anomaddev/Brewski/README.md

# Brewski

Brewski is a local web controller for a small still. A Python program runs the heater logic and stores every run. A plain JavaScript dashboard, in a dark layout, shows live temperatures, heater state, and the history of those runs.

The installed controller drives the live Pi wiring: the heater SSRs, the MAX31865 still probes, and the HTS221 cabinet sensor. `brewski dev` on a Mac uses a **dummy source** that simulates a still, so the dashboard can be built without that hardware. The installed service never falls back to the dummy source.

## What a run does

A run is one session of the still.

- **First launch.** A new controller, and one that has just had all data reset, opens a setup overlay. It asks for the heaters, the probes, the panel pins, the SPI and I2C bus, the target temperature, and the still size in gallons. A normal run stays locked until a calibration has measured the coast.
- **Idle.** The probes still report temperature. Heaters are off. Nothing new is written to the log unless the previous run is still cooling down.
- **Start.** Brewski copies the current setup onto the run: target temperature, which heaters and probes are enabled, their names, and their GPIO pins. The clock starts at zero. Starting during a cooldown leaves that cooldown unfinished, and it is left out of the average. Start is refused until a calibration has been saved.
- **Running.** About once a second the controller reads the probes. **The first enabled probe is the only one that controls the heaters.** Enabled heaters turn off early, by the early cutoff (3°F unless changed in Settings), so heat still stored in the element can carry the liquid the rest of the way to the target. Without a measured cooling rate they turn back on when the probe falls 2°F below that cutoff, and between those two points they stay as they are. Once calibration has measured how fast the pot cools, a run still turns the elements off at the cutoff. Near the target they stay off until the probe sags about 1°F, then run one short pulse timed from that cooling rate, instead of waiting until the probe has fallen the whole coast. A heater that has just turned on stays on for at least the minimum on time, and one that has just turned off stays off for at least the minimum off time (each 1 second unless changed). Both dwells keep a zero-crossing SSR from chattering. Pause and Stop still turn the heaters off immediately. Disabled heaters stay off. Every 5 seconds a sample is saved: each probe temperature, each heater on or off, and the target at that moment.
- **Pause.** Heaters are forced off and the run clock stops. Live temperatures are still shown. Paused time is not added to the log.
- **Stop.** Heaters turn off, the run is closed as **Stopped**, and the setup snapshot plus the sample log stay in the history.
- **Calibrate.** From the dashboard, with the pot filled with water, Calibrate heats until the control probe is a little above the target. The early cutoff is not used, so the still can actually reach the setpoint and coast past it. Once the element has been hot for 30 seconds and turns off, Brewski watches a rolling average of that probe until the average crests and turns down. A slow climb does not end the run. The degrees from shutoff to that peak, and how long that took, become the early cutoff. Brewski then leaves the elements off and measures how fast the pot cools, in °F per minute. The LCD names each step: Heating, Coasting with the live rise, Falling with the peak and then the rate, and Paused with the step that was interrupted. After the run closes, the cooling screen shows the saved coast and the rate. The calibration uses the still size from setup. A different size on a later calibration scales the remembered coast and the cooling rate, then the measurement replaces them. An older coast that has no cooling rate still allows a run, and the dashboard asks for another calibration. Calibration runs stay in the log with their own badge and are left out of the run count, average duration, average cooldown, and the per-run heater-on totals. They still add to each element's hour meter, because the element was powered.
- **Cooldown.** A cooldown is the stretch from the target temperature to the lower stop. Timing starts the first time the control probe reaches the target, including the rest of the run. After Stop, heaters stay off, and the lower stop is when that probe stays inside a 2°F band for 5 minutes. Those readings stay on the dashboard chart, and the time is saved. The dashboard and the history page show the average of every finished cooldown. A run that never reaches its target has no cooldown.

Each heater and each probe can be enabled or disabled on its own. Changing names, which devices are enabled, a heater's GPIO pin, a probe's MAX31865 chip select, RTD, wire count, or reference resistor, or any other GPIO pin, is locked while a run is open. The target temperature, the cabinet limit, the early cutoff, and the minimum on and off times can still be changed; later samples record the new target, and the run keeps the target it started with. The target dial on the panel changes that same target by 1°F, from 90 to 240.

The HTS221 is not a process temperature. It watches the cabinet. If it is enabled and the cabinet rises above the cabinet limit (170°F unless changed, allowed from 100 to 200), Brewski opens every SSR immediately, stops and saves an open run, and refuses Start until the cabinet is back at the limit. The controller process keeps running so the SSR pins stay driven off. Humidity is shown and does not trip the stop. Disabling the HTS221 turns the interlock off.

## Emergency codes

`src/brewski/emergency.py` is the only list. A new fault takes the next number there and a line here. Numbers are not reused. The LCD shows the lowest active code. The dashboard and the status strip show every active code and its sentence. Heaters stay off and Start stays refused while any code is active.

- `E01` — cabinet temperature is above the cabinet limit.
- `E02` — the HTS221 is enabled and does not answer.
- `E03` — the control probe faulted or did not answer.
- `E04` — the SPI bus did not open, or the saved SPI pins are not the hardware bus.

Any enabled probe after the control probe is logged and charted only. It does not decide when the heaters fire.

## Pi source

`brewski` with no command, including the systemd service, uses `src/brewski/sources/pi.py`. There is no switch back to the dummy source. A missing still probe or a failed SPI open leaves that reading empty and keeps every SSR off. A missing HTS221 trips the cabinet emergency only when that sensor is enabled.

- **SSRs.** gpiozero outputs on each heater's BCM pin, active high. Forced off on startup, shutdown, pause, stop, a control-probe fault, and any emergency code. Defaults are BCM 12 and 16.
- **MAX31865.** Hardware SPI0 only when the saved pins are CLK 11, MOSI 10, and MISO 9. Chip select is a separate GPIO, so probe 1 can use BCM 17. The driver uses the saved wire count, PT100 or PT1000 type, and reference resistor. Any other SPI pin set is left unread.
- **HTS221.** smbus2 on I2C bus 1 at `0x5F`, only when the sensor is enabled and SDA/SCL are BCM 2 and 3.

The LCD is a 20×4 I2C display on the saved SDA and SCL pins, after setup. Saved BCM 2 and 3 use the Pi's hardware bus. The running controller keeps the start and stop buttons, their LED relays, and the target encoder open. An LED is solid on only while that button will do something. While Stop is held, its lamp stays dark until the hold is long enough, then comes on, and goes out again when the button is released. The boot update prompt turns both LEDs on and does not blink them.

Holding Stop for 4 seconds while the still is idle or cooling opens a Software Menu on that display: About, Check for Update, and Reboot. The same hold opens it while an emergency code is showing, so the still can be rebooted or updated without the dashboard. The dial moves the highlight, Start chooses it, and Stop goes back. The hold is ignored during a run or a pause, and a short press of Stop still stops a running or paused run. Check for Update uses the same installer as the dashboard. Reboot asks for confirmation, then reboots the Pi. The install grants the service account passwordless `systemctl reboot` for that.

The installer enables SPI and I2C and adds the service user to the `spi`, `i2c`, and `gpio` groups. The Pi may need one reboot before `/dev/spidev0.0` appears.

## Dummy source

`DummySource` is only for `brewski dev` on a Mac, and for tests. Two heaters together lift the boiler from about 70°F toward a 165°F target in a few minutes. That is faster than a real still, on purpose, so the chart moves while the UI is being designed. After the heaters turn off, stored element heat keeps raising the boiler for a few seconds, then it cools back toward room temperature. Sensor 2 lags sensor 1 and sits about 8°F cooler. The cabinet reading stays at room temperature, under the limit.

The status payload includes `"source": "dummy"` for dev and `"source": "pi"` on the installed controller. The dashboard badge reads **Dummy source** or **Pi**. The dummy source ignores heater, probe, and SPI pin numbers.

- `read_temperatures(count)` returns `count` temperatures in °F, sensor 1 first.
- `set_heaters(states)` turns each heater on or off, heater 1 first.

Those methods live in `src/brewski/sources/base.py`. The dummy implementation is `src/brewski/sources/dummy.py`.

## Develop on a Mac

From a checkout of this repo:

```bash
python3 -m venv .venv
source .venv/bin/activate
pip install -e ".[dev]"
npm install --prefix web
brewski dev
```

- API: http://127.0.0.1:5000
- Dashboard: http://127.0.0.1:5173

The Vite dev server reloads the UI as you edit `web/`, and it proxies `/api` to the Python process. The database for dev mode is `./data/brewski.db`.

`BREWSKI_HOST`, `BREWSKI_PORT`, and `BREWSKI_DATA_DIR` override the API bind address and the database directory. `BREWSKI_DEV_PORT` changes the Vite port (default 5173).

Run the tests with `pytest`.

## Install on a Raspberry Pi

Git is not required. On the Pi:

```bash
curl -fsSL https://raw.githubusercontent.com/anomaddev/Brewski/main/deploy/install.sh | sudo bash
```

That installs the latest GitHub release, then enables a systemd service so the controller starts on every reboot. The database is kept at `/var/lib/brewski/brewski.db`. The service listens on port 8080. Open `http://<pi-address>:8080`.

A fresh boot does not look for an update. The I2C pins are not known until setup saves them, and the LCD stays closed. Finish setup in the dashboard first. That write is stored before any update check. If a newer release exists, the same screen offers it. Update installs that release and keeps the setup that was just saved. Not now leaves the current version running.

The next boot, once setup is saved, asks on the LCD when a newer release exists. Start and Stop are both lit, solid. Start downloads and installs it, with each stage on the display. Stop, or a minute with no press, starts the version already on the Pi. If GitHub cannot be reached, the LCD cannot be opened, or the saved pins are not BCM 2 and 3, Brewski starts the installed version and does not update on its own. Commits on `main` stay off the Pi until they are published as a release. After the controller is up, the LCD shows the mode and clock, the target, the probe or probes, and both heaters. During a calibration those first lines name the step instead: Heating, Coasting, Falling, and then the saved coast and cooling rate while the pot cools. A still that has never been calibrated asks for Start. An emergency code replaces that screen until it clears.

The service runs as the account that invoked `sudo`, or as `pi` when that account exists and sudo did not record a user. Set `BREWSKI_USER` to choose a different account:

```bash
curl -fsSL https://raw.githubusercontent.com/anomaddev/Brewski/main/deploy/install.sh \
  | sudo BREWSKI_USER=still bash
```

From a checkout that is already on the Pi, `sudo ./deploy/install.sh` installs that checkout and does not contact GitHub.

Running the script again upgrades Brewski and restarts the service. It does not delete the database. Dev mode (`brewski dev`) does not need this install.

## What is stored

SQLite, one file. There is no separate database server.

**Settings** (one row): the target in °F, the cabinet limit, and for each of the two heaters and two probes a name, an enabled switch, and a BCM pin. A heater pin drives its SSR. A probe pin is the chip select of that probe's MAX31865. A probe name is 1 to 11 characters. A heater name can be 40. The same row stores the rest of the BCM map: SPI CLK, SDO, and SDI; I2C SDA and SCL; enable switches for the HTS221 and the LCD on that bus; encoder A and B; the start and stop LED relays; and the start and stop buttons. Every pin in that map, including both heaters and both chip selects, must be unique and from BCM 2 to 27. Each probe also stores its RTD (`pt100` or `pt1000`), wire count (2, 3, or 4), and reference resistor in ohms. Disabling a device keeps its name and wiring. Defaults are BCM 12 and 16 for the heaters and chip selects BCM 17 and 8 for the probes. Probe 2 starts disabled. SPI defaults are BCM 11, 9, and 10. I2C defaults are BCM 2 and 3, with the HTS221 and the LCD enabled. The encoder defaults are BCM 27 and 22, the LED relays BCM 23 and 24, and the buttons BCM 5 and 6. Each probe starts as a 2-wire PT100 with a 430 Ω reference. The allowed target range is 90–240°F. The cabinet limit defaults to 170°F and accepts 100–200. I2C addresses are not stored. The LCD probes `0x27`, then `0x3F`.

**Runs:** start time, end time, status (`running`, `paused`, or `stopped`), elapsed seconds (the pause does not add time), and a snapshot of the settings from the moment Start was pressed.

**Samples:** time, elapsed seconds, temperatures, heater states, and the target that was active when the sample was written.

Time each heater spent on during a run is estimated from that log and shown on the history page. A sample's heater state is treated as holding until the next sample.

**Element hours:** seconds each heater output has actually been on, including calibration and every run. The controller adds that time as it happens and keeps it when run data is reset. The dashboard, the history overview, and Settings show the total in hours. Replacing an element in Settings zeros that heater so the new one starts at zero. A database from before this meter existed is filled once from its sample log.

## Layout

```
src/brewski/          Python controller, API, and CLI
src/brewski/sources/  Hardware contract, the Pi source, and the Mac dummy still
web/                  Vite dashboard (plain JavaScript, no TypeScript)
deploy/               Pi install script and systemd unit
tests/
```

`brewski` with no arguments serves the API and, when it has been built, the dashboard. `brewski dev` is the Mac development command described above.
