anomaddev/Brewski/pcb_design/Brewski Pi Still Controller HAT/Project Brief.md

# Brewski Pi Still Controller HAT

A Raspberry Pi HAT for a small still controller featuring an integrated I2C hub, SSR control headers for external heater relays, optoisolated indicator lamp drivers, and interfaces for temperature probes, a rotary dial, and momentary switches.
