anomaddev/Brewski/pcb_design/Brewski Pi Still Controller HAT/.protoflow/studio/knowledge.md

# Brewski Pi HAT: project knowledge
Pi HAT: 5V in, SSR drivers, MOC3063 lamp drivers, STEMMA I2C hub, probe sockets, encoder/button terminals.

## Status
- Phase: Choosing parts
- 5V input & rails: planned
- SSR drivers: planned
- Lamp optocouplers (mains side): planned
- Buttons & dial: planned
- STEMMA hub: planned
- MAX31865 sockets: planned
- Pi header: planned

## Next steps
1. Select and import parts
2. Build schematic
3. ERC
