anomaddev/Brewski/pcb_design/Brewski Pi Still Controller HAT/.protoflow/previews/schematic-5.png

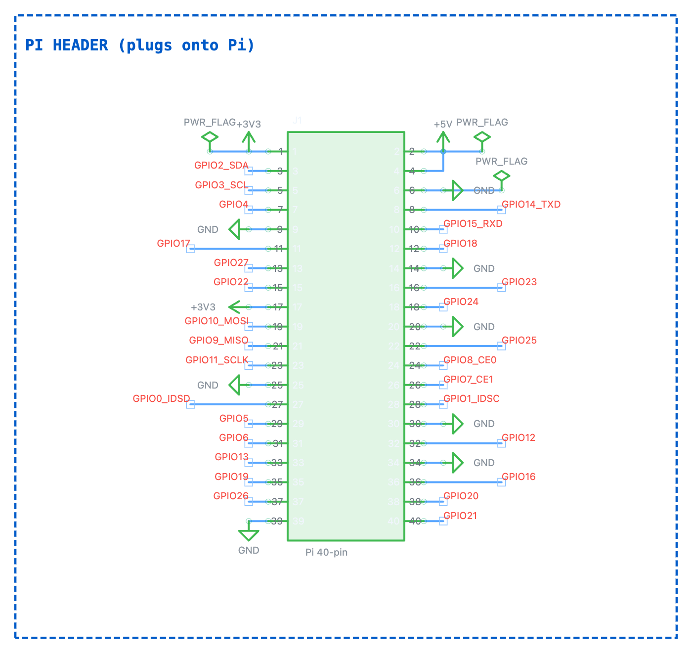
pcb_design/Brewski Pi Still Controller HAT/.protoflow/previews/schematic-5.png
