anomaddev/Brewski/(list of files, drawings)

Other design files:
pcb_design/Brewski Pi Still Controller HAT/.protoflow/studio/schematic-build.json
