anomaddev/Brewski/pcb_design/Brewski Pi Still Controller HAT/Brewski Pi Still Controller HAT.kicad_sch

## KiCad design pcb_design/Brewski Pi Still Controller HAT/Brewski Pi Still Controller HAT.kicad_sch (2026-10-19)

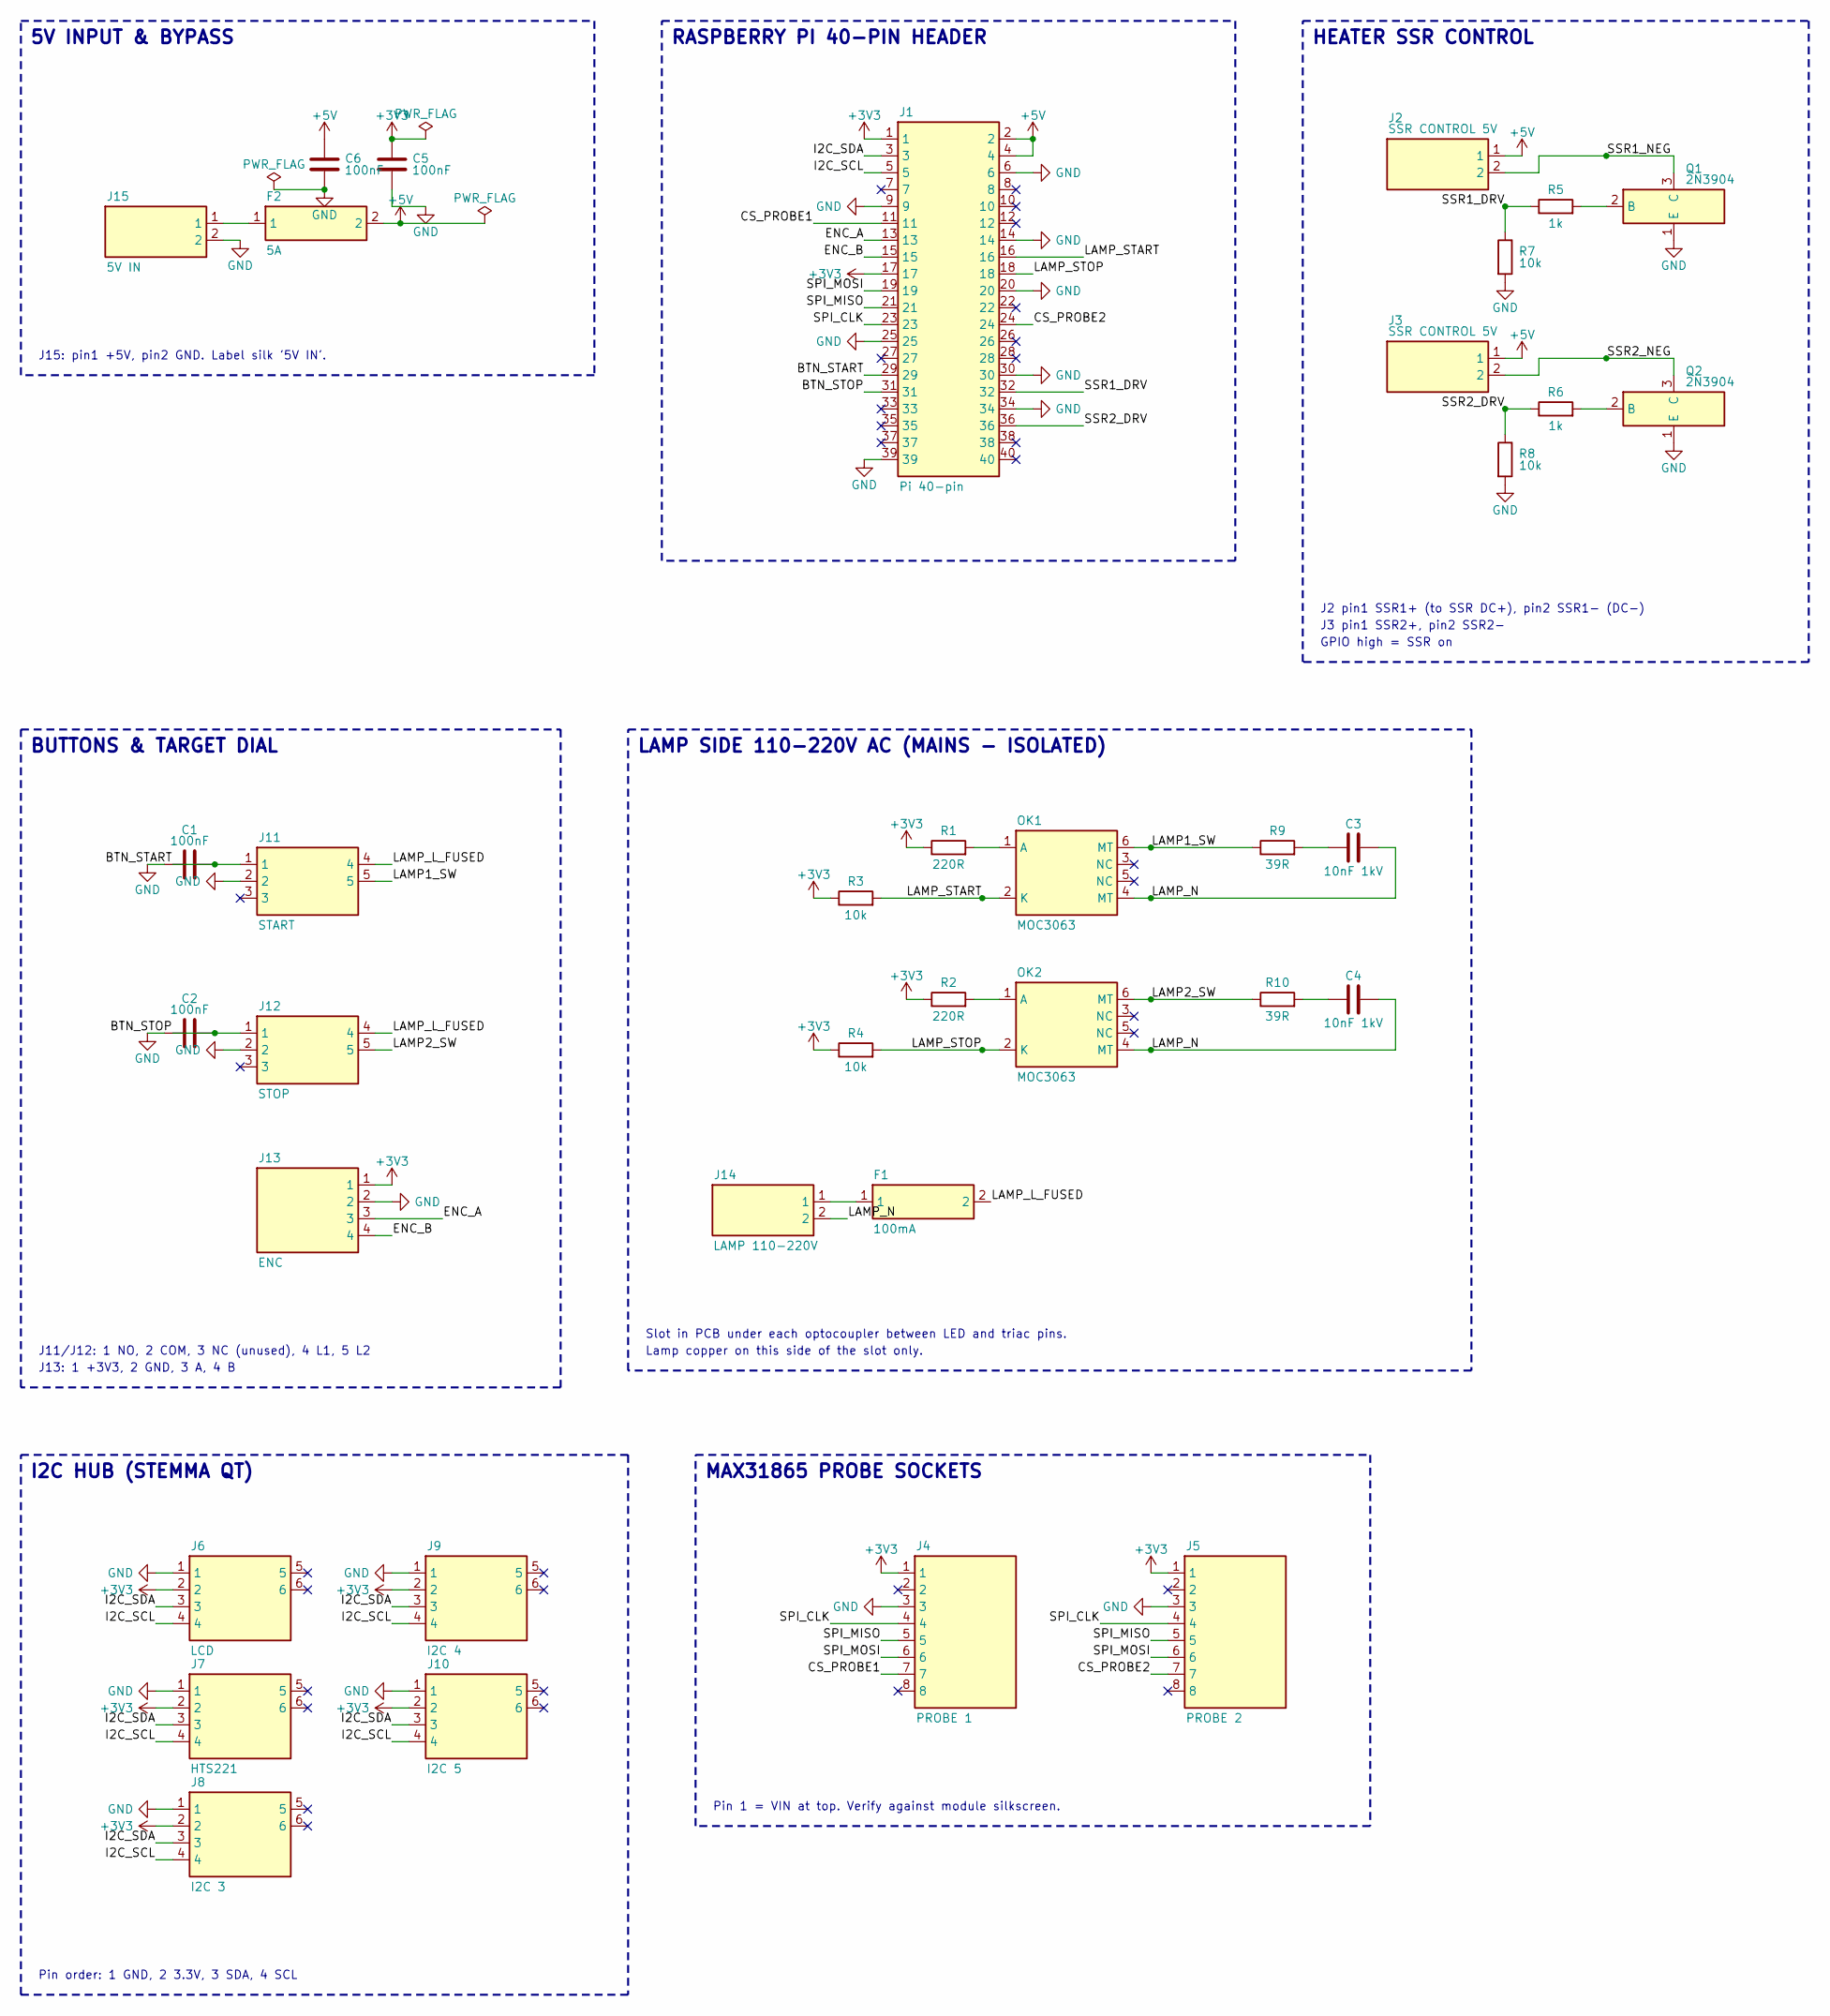
[picture p7: schematic Brewski Pi Still Controller HAT.kicad_sch]

Parts:
C1, C2, C5, C6: 100nF; C_0805_2012Metric; LCSC C49678
C3, C4: 10nF 1kV; C_1206_3216Metric; LCSC C394163
F1: 100mA; FUSE-TH_L8.4-W4.0-P5.08-D0.6; MPN JFS0100TR; LCSC C55042406
F2: 5A; FUSE-SMD_L9.8-W5.1; MPN 0154005.DR; LCSC C206916
J1: Pi 40-pin; HDR-TH_40P-P2.54-V-F-R2-C20-S2.54; MPN 2.54-2*20; LCSC C2977589
J2, J3: SSR CONTROL 5V; CONN-TH_P5.08_KF128-5.08-2P; MPN KF128-5.08-2P-AA; LCSC C474952
J4: PROBE 1; HDR-TH_8P-P2.54-V-F; MPN 2.54-1*8P母环保; LCSC C27438
J5: PROBE 2; HDR-TH_8P-P2.54-V-F; MPN 2.54-1*8P母环保; LCSC C27438
J6: LCD; CONN-SMD_4P-P1.00_SM04B-SRSS-TB-LF-SN; MPN SM04B-SRSS-TB(LF)(SN); LCSC C160404
J7: HTS221; CONN-SMD_4P-P1.00_SM04B-SRSS-TB-LF-SN; MPN SM04B-SRSS-TB(LF)(SN); LCSC C160404
J8: I2C 3; CONN-SMD_4P-P1.00_SM04B-SRSS-TB-LF-SN; MPN SM04B-SRSS-TB(LF)(SN); LCSC C160404
J9: I2C 4; CONN-SMD_4P-P1.00_SM04B-SRSS-TB-LF-SN; MPN SM04B-SRSS-TB(LF)(SN); LCSC C160404
J10: I2C 5; CONN-SMD_4P-P1.00_SM04B-SRSS-TB-LF-SN; MPN SM04B-SRSS-TB(LF)(SN); LCSC C160404
J11: START; CONN-TH_5P-P5.08_DIBO_DB128V-5.08-5P-GN-S; MPN DB128V-5.08-5P-GN-S; LCSC C2927513
J12: STOP; CONN-TH_5P-P5.08_DIBO_DB128V-5.08-5P-GN-S; MPN DB128V-5.08-5P-GN-S; LCSC C2927513
J13: ENC; CONN-TH_4P-P5.08_DIBO_DB128V-5.08; MPN DB128V-5.08-4P-GN-S; LCSC C2915641
J14: LAMP 110-220V; CONN-TH_P5.08_KF128-5.08-2P; MPN KF128-5.08-2P-AA; LCSC C474952
J15: 5V IN; CONN-TH_P5.08_KF128-5.08-2P; MPN KF128-5.08-2P-AA; LCSC C474952
OK1, OK2: MOC3063; DIP-6_L8.5-W6.4-P2.54-LS7.6-BL; MPN MOC3063M; LCSC C8920
Q1, Q2: 2N3904; SOT-23-3_L2.9-W1.3-P1.90-LS2.4-TR; MPN 2N3904S-RTK/PS; LCSC C18536
R1, R2: 220R; R_0805_2012Metric; LCSC C17557
R3, R4, R7, R8: 10k; R_0805_2012Metric; LCSC C17414
R5, R6: 1k; R_0805_2012Metric; LCSC C17513
R9, R10: 39R; R_0805_2012Metric; LCSC C543525

Connections:
+3V3: C5.1, J1.1, J1.17, J4.1, J5.1, J6.2, J7.2, J8.2, J9.2, J10.2, J13.1, R1.1, R2.1, R3.1, R4.1
+5V: C6.1, F2.2, J1.2, J1.4, J2.1, J3.1
BTN_START: C1.2, J1.29, J11.1
BTN_STOP: C2.2, J1.31, J12.1
CS_PROBE1: J1.11, J4.7
CS_PROBE2: J1.24, J5.7
ENC_A: J1.13, J13.3
ENC_B: J1.15, J13.4
GND: C1.1, C2.1, C5.2, C6.2, J1.6, J1.9, J1.14, J1.20, J1.25, J1.30, J1.34, J1.39, J4.3, J5.3, J6.1, J7.1, J8.1, J9.1, J10.1, J11.2, J12.2, J13.2, J15.2, Q1.1 (E), Q2.1 (E), R7.2, R8.2
I2C_SCL: J1.5, J6.4, J7.4, J8.4, J9.4, J10.4
I2C_SDA: J1.3, J6.3, J7.3, J8.3, J9.3, J10.3
LAMP1_SW: J11.5, OK1.6 (MT), R9.1
LAMP2_SW: J12.5, OK2.6 (MT), R10.1
LAMP_L_FUSED: F1.2, J11.4, J12.4
LAMP_N: C3.2, C4.2, J14.2, OK1.4 (MT), OK2.4 (MT)
LAMP_START: J1.16, OK1.2 (K), R3.2
LAMP_STOP: J1.18, OK2.2 (K), R4.2
unnamed: C3.1, R9.2
unnamed: C4.1, R10.2
unnamed: F1.1, J14.1
unnamed: F2.1, J15.1
unnamed: OK1.1 (A), R1.2
unnamed: OK2.1 (A), R2.2
unnamed: Q1.2 (B), R5.2
unnamed: Q2.2 (B), R6.2
SPI_CLK: J1.23, J4.4, J5.4
SPI_MISO: J1.21, J4.5, J5.5
SPI_MOSI: J1.19, J4.6, J5.6
SSR1_DRV: J1.32, R5.1, R7.1
SSR1_NEG: J2.2, Q1.3 (C)
SSR2_DRV: J1.36, R6.1, R8.1
SSR2_NEG: J3.2, Q2.3 (C)

Notes on the sheet:
5V INPUT & BYPASS
J15: pin1 +5V, pin2 GND. Label silk '5V IN'.
RASPBERRY PI 40-PIN HEADER
HEATER SSR CONTROL
J2 pin1 SSR1+ (to SSR DC+), pin2 SSR1- (DC-)
J3 pin1 SSR2+, pin2 SSR2-
GPIO high = SSR on
BUTTONS & TARGET DIAL
J11/J12: 1 NO, 2 COM, 3 NC (unused), 4 L1, 5 L2
J13: 1 +3V3, 2 GND, 3 A, 4 B
LAMP SIDE 110-220V AC (MAINS - ISOLATED)
Slot in PCB under each optocoupler between LED and triac pins.
Lamp copper on this side of the slot only.
I2C HUB (STEMMA QT)
Pin order: 1 GND, 2 3.3V, 3 SDA, 4 SCL
MAX31865 PROBE SOCKETS
Pin 1 = VIN at top. Verify against module silkscreen.
