anomaddev/Brewski/pcb_design/Brewski Pi Still Controller HAT/breakout/Pi Header Breakout.kicad_sch

## KiCad design pcb_design/Brewski Pi Still Controller HAT/breakout/Pi Header Breakout.kicad_sch (2026-10-19)

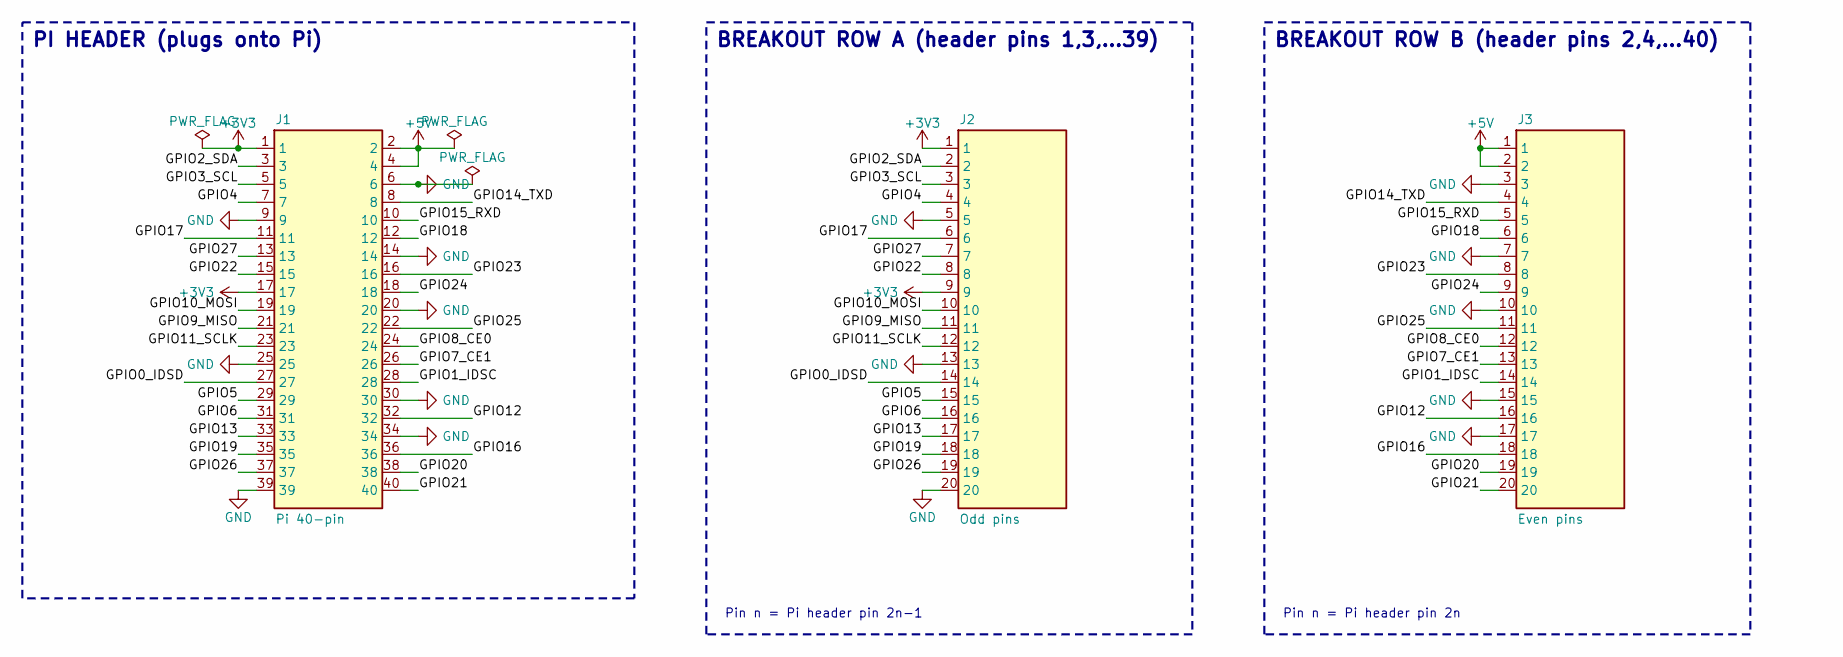
[picture p8: schematic Pi Header Breakout.kicad_sch]

Parts:
J1: Pi 40-pin; HDR-TH_40P-P2.54-V-F-R2-C20-S2.54; MPN 2.54-2*20; LCSC C2977589
J2: Odd pins; HDR-TH_20P-P2.54-V-M-1; MPN 2.54-1*20P直针; LCSC C50981
J3: Even pins; HDR-TH_20P-P2.54-V-M-1; MPN 2.54-1*20P直针; LCSC C50981

Connections:
+3V3: J1.1, J1.17, J2.1, J2.9
+5V: J1.2, J1.4, J3.1, J3.2
GND: J1.6, J1.9, J1.14, J1.20, J1.25, J1.30, J1.34, J1.39, J2.5, J2.13, J2.20, J3.3, J3.7, J3.10, J3.15, J3.17
GPIO0_IDSD: J1.27, J2.14
GPIO1_IDSC: J1.28, J3.14
GPIO2_SDA: J1.3, J2.2
GPIO3_SCL: J1.5, J2.3
GPIO4: J1.7, J2.4
GPIO5: J1.29, J2.15
GPIO6: J1.31, J2.16
GPIO7_CE1: J1.26, J3.13
GPIO8_CE0: J1.24, J3.12
GPIO9_MISO: J1.21, J2.11
GPIO10_MOSI: J1.19, J2.10
GPIO11_SCLK: J1.23, J2.12
GPIO12: J1.32, J3.16
GPIO13: J1.33, J2.17
GPIO14_TXD: J1.8, J3.4
GPIO15_RXD: J1.10, J3.5
GPIO16: J1.36, J3.18
GPIO17: J1.11, J2.6
GPIO18: J1.12, J3.6
GPIO19: J1.35, J2.18
GPIO20: J1.38, J3.19
GPIO21: J1.40, J3.20
GPIO22: J1.15, J2.8
GPIO23: J1.16, J3.8
GPIO24: J1.18, J3.9
GPIO25: J1.22, J3.11
GPIO26: J1.37, J2.19
GPIO27: J1.13, J2.7

Notes on the sheet:
PI HEADER (plugs onto Pi)
BREAKOUT ROW A (header pins 1,3,...39)
Pin n = Pi header pin 2n-1
BREAKOUT ROW B (header pins 2,4,...40)
Pin n = Pi header pin 2n
