anomaddev/Brewski/src/brewski/controller.py

"""Run state machine.

The loop is hardware-agnostic. It reads a :class:`HardwareSource`, decides
whether the heaters should be on, and appends samples while a run is going.
A timeline reading is saved on the same cadence whether or not a run is open,
so the dashboard can scroll the controller clock after a reload.
The first enabled probe is the one compared with the target. Once a
calibration has saved a heating model, heaters turn off when the predicted
crest reaches the target, stay off while that projected coast is still
arriving, then hold the target with pulses sized on the heater-on curve
so they land on it, and not past it, until the run stops, the hold
timer ends, or the max program duration is reached.
Until that model exists they turn off by the measured coast, and sooner
when the pot is rising faster than that measurement, so heat still stored
in the element can finish the rise. Disabled heaters stay off.
The installed service drives the SSRs,
the MAX31865 probes, and the HTS221. After setup, this loop also drives
the I2C LCD, the panel buttons, the LED relays, and the target encoder.
"""

from __future__ import annotations

import io
import logging
import math
import subprocess
import threading
import time
import weakref
import zipfile
from dataclasses import replace

from brewski import __version__, analysis
from brewski.calibration import MARK_HOLDING, MARK_START, CalibrationSession
from brewski.consolelog import ConsoleCapture, console_log_text
from brewski.emergency import summary
from brewski.lcd import (
    Display,
    NullDisplay,
    display_key,
    open_display,
    startup_lines,
    status_lines,
    suite_result_lines,
    suite_run_lines,
)
from brewski.menu import SoftwareMenu
from brewski.network import display_identity
from brewski.panel import indicator_leds, open_panel, panel_key
from brewski.program import MAX_DURATION_SECONDS, Program, program_end
from brewski.runlog import (
    analysis_message,
    clean_detail,
    decision_fields,
    control_log_csv,
    format_control,
    model_message,
    model_numbers,
    suite_result_message,
    phase_keys,
    phase_message,
    start_message,
)
from brewski.sources.base import HardwareSource
from brewski.suite import TEST_INITIAL_HEATING, InitialHeatingSession
from brewski.updates import (
    ReleaseInfo,
    apply_supported,
    check_release,
    installed_revision,
    read_status,
    report as update_report,
    request_reboot,
    start_apply_service,
    write_status,
)
from brewski.store import (
    EARLY_CUTOFF_MAX_F,
    SLOT_COUNT,
    TARGET_MAX_F,
    TARGET_MIN_F,
    Settings,
    SettingsError,
    Store,
    charge_gallons,
    default_gpio,
    heater_on_seconds,
    merge_settings,
    shape_changed,
    utc_now,
)
from brewski.thermal import (
    CALIBRATION_TEMP_F,
    HOLD_BAND_F,
    HOLD_RISE_F_PER_SEC,
    HOLD_SLOPE_MIN_SPAN_SECONDS,
    HOLD_SLOPE_WINDOW_SECONDS,
    LEARN_TEMP_F,
    GROK_RATE_BAND_F_PER_MIN,
    GROK_RATE_BAND_F_PER_SEC,
    ARRIVAL_F,
    GROK_RISE_BAND_F,
    SAFE_TEMP_F,
    ThermalModel,
    accept_grok,
    apply_grok_value,
    blend_model,
    coast_entry_slope,
    coast_settle_seconds,
    coast_tau_of,
    endpoint_rate,
    hold_maintenance_plan,
    hold_pulse_landing,
    model_from_dict,
    project_temperature,
    pulse_plan,
    remaining_coast_f,
    scale_model,
    seconds_to_landing,
    step_sheath_slope,
)
from brewski.timeline import TIMELINE_COMPACT_SECONDS

logger = logging.getLogger(__name__)

# Width of the hysteresis band. The element turns back on only after the
# probe falls this far below the early-cutoff temperature.
DEADBAND_F = 2.0
# After a run, cooldown stays open while the control probe is above 100°F.
SAMPLE_INTERVAL_SECONDS = 5.0
# The control log keeps each control-loop reading. The loop decides about
# once a second, and a 5 second gap hides the slope and the shutoff.
LOG_INTERVAL_SECONDS = 1.0
# The run page asks for one of these. Anything else would turn a review into
# another full-table read.
REVIEW_PAGE_SIZES = (10, 25, 50, 100)
REVIEW_EVENTS = ("start", "sample", "heat", "phase", "model", "analysis", "test")
REVIEW_CLOCKS = ("run", "cooldown", "both")
# Ignore a stalled clock that tries to replay more than an hour in one tick.
MAX_TICK_SECONDS = 3600.0
# A calibration only trusts a coast after the element has been on long enough
# to be hot. Shorter pulses still have a cold sheath and teach the wrong number.
COAST_SOAK_SECONDS = 30.0
# After that soaked shutoff, the coast is the rise in a rolling average of the
# control probe, measured at the crest. A slow climb is still climbing.
COAST_AVERAGE_SECONDS = 10.0
# The crest is real once the average has fallen this far below its high and
# stayed there. The saved coast is the high itself, not this confirmation dip.
COAST_PEAK_DROP_F = 0.4
COAST_PEAK_CONFIRM_SECONDS = 10.0
# A pot that levels off without a clear drop. The high must gain this much
# to keep the watch open.
COAST_PLATEAU_RISE_F = 0.2
COAST_PLATEAU_SECONDS = 90.0
COAST_WATCH_MAX_SECONDS = 20 * 60
# After the crest, how fast the pot falls with the elements off.
COOLDOWN_MIN_DROP_F = 1.0
COOLDOWN_MIN_SECONDS = 45.0
COOLDOWN_AGREE_SECONDS = 30.0
COOLDOWN_RATE_AGREE_F = 0.2
COOLDOWN_RATE_AGREE_FRACTION = 0.25
COOLDOWN_WATCH_MAX_SECONDS = 4 * 60
COOLDOWN_RATE_MAX = 120.0
# A sustain pulse is sized so its guessed coast replaces about this much sag.
SUSTAIN_RIPPLE_F = 1.0
# Reached the target when the crest is at least this close to it.
# Above the target counts: that overshoot is what the calibration records.
CALIBRATION_LAND_F = 0.5
# Control-probe samples kept for the live rise or fall. Short enough that a
# change in heater count shows up, long enough that one noisy reading does not.
PREDICT_WINDOW_SECONDS = 15.0
# No slope until the window holds this many points and this much time. A single
# jumped reading is not a rate.
PREDICT_MIN_SAMPLES = 4
PREDICT_MIN_SPAN_SECONDS = 8.0
# Flatter than this is not moving. A stalled probe does not invent an ETA.
PREDICT_MIN_RATE_F_PER_SEC = 0.01
# Both estimates stop here. A cold pot must not report a multi-day climb.
PREDICT_MAX_HORIZON_SECONDS = 4 * 60 * 60
# A fast rise may shut off sooner than the learned coast, but not by more than
# this multiple, and never by more than EARLY_CUTOFF_MAX_F degrees.
PREDICT_COAST_SCALE_MAX = 3.0
# A late slope this close to the early one is still a straight line. The
# flattening fit waits until the rise has clearly slowed.
COAST_TAU_SLOW_FRACTION = 0.85
# Below this fraction the sheath is still leaving cold, and the shallow slope
# is not yet the straight-line rate. At SOAK_FULL the full coast applies.
SOAK_RAMP_MIN = 0.2
SOAK_FULL = 0.9
# A falling pot is reported against the safe-to-handle line, not room temperature.


def scaled_cutoff(
    learned_coast_f: float | None,
    learned_gallons: float | None,
    new_gallons: float | None,
) -> float | None:
    """Scale a remembered coast when the charge volume changes.

    The same stored heat adds more degrees to a smaller charge. Returns None
    when there is nothing to scale, including a repeat at the same volume.
    """

    if learned_coast_f is None or learned_gallons is None or new_gallons is None:
        return None
    if learned_gallons == new_gallons:
        return None
    scaled = learned_coast_f * (learned_gallons / new_gallons)
    return min(EARLY_CUTOFF_MAX_F, max(0.0, round(scaled, 2)))


def scaled_rate(
    learned_rate: float | None,
    learned_gallons: float | None,
    new_gallons: float | None,
) -> float | None:
    """Scale a cooling rate when the charge volume changes.

    The same heat loss changes the temperature of a smaller charge faster.
    Returns None when there is nothing to scale, including a repeat at the
    same volume.
    """

    if learned_rate is None or learned_gallons is None or new_gallons is None:
        return None
    if learned_gallons == new_gallons:
        return None
    scaled = learned_rate * (learned_gallons / new_gallons)
    return min(COOLDOWN_RATE_MAX, max(0.0, round(scaled, 2)))


def sustain_pulse_seconds(
    coast_f: float,
    coast_seconds: float,
    *,
    ripple_f: float = SUSTAIN_RIPPLE_F,
) -> float | None:
    """On-time whose guessed coast replaces about ``ripple_f`` degrees.

    A fully hot element coasts ``coast_f`` degrees over ``coast_seconds``.
    A shorter on-time coasts less, approximately
    ``coast_f * (1 - exp(-t / coast_seconds))``. Returns None when the full
    coast is already as small as the ripple, because a shorter pulse cannot
    shrink it.
    """

    if coast_f <= ripple_f or coast_seconds <= 0 or ripple_f <= 0:
        return None
    fraction = min(0.999, ripple_f / coast_f)
    seconds = -float(coast_seconds) * math.log(1.0 - fraction)
    return max(1.0, seconds)


def reheat_temperature(
    target_f: float,
    cool_f_per_min: float,
    pulse_seconds: float,
    *,
    ripple_f: float = SUSTAIN_RIPPLE_F,
) -> float:
    """Probe temperature where a sustain pulse should start.

    The pulse begins early by the degrees the pot will fall, at the learned
    cooling rate, during the pulse itself.
    """

    lead = (max(0.0, cool_f_per_min) / 60.0) * max(0.0, pulse_seconds)
    return float(target_f) - ripple_f - lead


def _slope_per_min(samples: list[tuple[float, float]], *, min_drop: float) -> float | None:
    start_t, start_v = samples[0]
    end_t, end_v = samples[-1]
    dt = end_t - start_t
    drop = start_v - end_v
    if dt <= 0 or drop < min_drop:
        return None
    return drop / dt * 60.0


def _cooling_progress(
    samples: list[tuple[float, float]],
    elapsed: float,
    average: float,
) -> tuple[float | None, bool]:
    """Append one falling average and report the rate and whether it is settled.

    The rate is °F per minute. Settled means the last 30 seconds agrees with
    the whole fall, or the watch has run for 4 minutes.
    """

    samples.append((elapsed, average))
    if len(samples) < 2:
        return None, False
    start_t = samples[0][0]
    end_t = samples[-1][0]
    duration = end_t - start_t
    full = _slope_per_min(samples, min_drop=COOLDOWN_MIN_DROP_F)
    if duration >= COOLDOWN_WATCH_MAX_SECONDS:
        return full, True
    if duration < COOLDOWN_MIN_SECONDS or full is None:
        return full, False
    window_start = end_t - COOLDOWN_AGREE_SECONDS
    recent = [(stamp, reading) for stamp, reading in samples if stamp >= window_start]
    if len(recent) < 2 or recent[-1][0] - recent[0][0] < COOLDOWN_AGREE_SECONDS - 1:
        return full, False
    recent_rate = _slope_per_min(recent, min_drop=0.05)
    if recent_rate is None:
        return full, False
    agrees = abs(recent_rate - full) <= COOLDOWN_RATE_AGREE_F or (
        full > 0 and abs(recent_rate - full) / full <= COOLDOWN_RATE_AGREE_FRACTION
    )
    if agrees:
        return recent_rate, True
    return full, False


def slope_f_per_sec(samples: list[tuple[float, float]]) -> float | None:
    """End-point °F/s over a window of ``(elapsed_seconds, temp_f)``.

    Positive is a rise. Returns None until the window is long enough to trust.
    """

    if len(samples) < PREDICT_MIN_SAMPLES:
        return None
    start_t, start_v = samples[0]
    end_t, end_v = samples[-1]
    dt = end_t - start_t
    if dt < PREDICT_MIN_SPAN_SECONDS:
        return None
    return (end_v - start_v) / dt


def predicted_coast_f(
    learned_coast_f: float | None,
    learned_coast_seconds: float | None,
    rate_f_per_sec: float | None,
) -> float:
    """Degrees the probe should still climb after the SSR opens.

    The learned coast is the floor. It is the residual heat measured at
    calibration, not a number from Settings. A faster live rise scales that
    coast up, because the same sheath dumps more degrees into a pot that is
    already climbing quickly. A slower rise does not shrink it. No learned
    coast, or no trustworthy positive slope, leaves the floor alone.
    """

    if learned_coast_f is None or learned_coast_f <= 0:
        return 0.0
    coast = min(EARLY_CUTOFF_MAX_F, float(learned_coast_f))
    if (
        rate_f_per_sec is None
        or rate_f_per_sec < PREDICT_MIN_RATE_F_PER_SEC
        or learned_coast_seconds is None
        or learned_coast_seconds <= 0
    ):
        return coast
    implied = coast / float(learned_coast_seconds)
    if implied <= 0:
        return coast
    scale = rate_f_per_sec / implied
    if scale < 1.0:
        scale = 1.0
    elif scale > PREDICT_COAST_SCALE_MAX:
        scale = PREDICT_COAST_SCALE_MAX
    return min(EARLY_CUTOFF_MAX_F, coast * scale)


def coast_tau_seconds(samples: list[tuple[float, float]]) -> float | None:
    """Time constant of a rise that is slowing down.

    The early and late windows each have to be long enough to trust a slope.
    Both slopes have to be rising, and the late one has to be clearly slower.
    ``tau = dt / ln(early / late)`` for a rate that decays as ``exp(-t / tau)``.
    """

    if len(samples) < PREDICT_MIN_SAMPLES * 2:
        return None
    start = samples[0][0]
    end = samples[-1][0]
    if end - start < PREDICT_MIN_SPAN_SECONDS * 2:
        return None
    early_end = start + PREDICT_MIN_SPAN_SECONDS
    late_start = end - PREDICT_MIN_SPAN_SECONDS
    if late_start < early_end:
        return None
    early = [(stamp, reading) for stamp, reading in samples if stamp <= early_end]
    late = [(stamp, reading) for stamp, reading in samples if stamp >= late_start]
    early_rate = slope_f_per_sec(early)
    late_rate = slope_f_per_sec(late)
    if (
        early_rate is None
        or late_rate is None
        or early_rate < PREDICT_MIN_RATE_F_PER_SEC
        or late_rate < PREDICT_MIN_RATE_F_PER_SEC
        or late_rate > early_rate * COAST_TAU_SLOW_FRACTION
    ):
        return None
    early_mid = (early[0][0] + early[-1][0]) / 2.0
    late_mid = (late[0][0] + late[-1][0]) / 2.0
    dt = late_mid - early_mid
    if dt <= 0 or early_rate <= late_rate:
        return None
    tau = dt / math.log(early_rate / late_rate)
    if tau < 1.0 or tau > COAST_WATCH_MAX_SECONDS:
        return None
    return tau


def sheath_soak(off_seconds: float, on_seconds: float, tau_seconds: float) -> float:
    """Fraction of a hot sheath, from 0 cold to 1 soaked.

    The same time constant fills the sheath after the SSR closes and empties
    it after the SSR opens. A long off interval starts from cold.
    """

    if tau_seconds <= 0:
        return 1.0
    off = max(0.0, off_seconds)
    if math.isinf(off) or off >= tau_seconds * 8.0:
        stored = 0.0
    else:
        stored = math.exp(-off / tau_seconds)
    on = max(0.0, on_seconds)
    return 1.0 - (1.0 - stored) * math.exp(-on / tau_seconds)


def projected_linear_rate(rate_f_per_sec: float | None, soak: float) -> float | None:
    """Straight-line °F/s the ramp is climbing toward.

    A cold sheath has not shown that rate yet. Returns None until the soak is
    far enough along, and the measured slope itself once the sheath is hot.
    """

    if rate_f_per_sec is None or rate_f_per_sec < PREDICT_MIN_RATE_F_PER_SEC:
        return None
    if soak >= SOAK_FULL:
        return rate_f_per_sec
    if soak < SOAK_RAMP_MIN:
        return None
    return rate_f_per_sec / soak


def seconds_along_coast(
    temp_f: float,
    target_f: float,
    rate_f_per_sec: float | None,
    tau_seconds: float | None,
) -> float | None:
    """Seconds to the target while the rise rate decays as ``exp(-t / tau)``.

    The degrees still to come are ``rate * tau``. Returns None when this coast
    crests short of the target, or when the rise is not real.
    """

    if temp_f >= target_f:
        return 0.0
    if (
        rate_f_per_sec is None
        or rate_f_per_sec < PREDICT_MIN_RATE_F_PER_SEC
        or tau_seconds is None
        or tau_seconds <= 0
    ):
        return None
    remaining = rate_f_per_sec * float(tau_seconds)
    gap = target_f - temp_f
    if remaining <= gap:
        return None
    seconds = -float(tau_seconds) * math.log(1.0 - gap / remaining)
    return min(PREDICT_MAX_HORIZON_SECONDS, max(0.0, seconds))


def tune_coast(
    learned_f: float | None,
    learned_seconds: float | None,
    used_f: float,
    rate_f_per_sec: float | None,
    miss_f: float,
    observed_seconds: float,
    tau_seconds: float | None = None,
) -> tuple[float, float | None]:
    """Learned coast and duration after a calibration landing.

    ``miss_f`` is the crest minus the calibration temperature. Positive means
    the shutoff was late. The coast that would have landed on that temperature
    is the coast the prediction used, plus the miss. A fitted time constant is
    kept when the same rise rate still predicts that corrected coast. Otherwise
    the duration is the one that makes :func:`predicted_coast_f` return it.
    With no fit, the time from shutoff to the crest stays the duration.
    """

    desired = min(EARLY_CUTOFF_MAX_F, max(0.0, float(used_f) + float(miss_f)))
    fitted = tau_seconds is not None and tau_seconds > 0
    rate_ok = (
        rate_f_per_sec is not None
        and rate_f_per_sec >= PREDICT_MIN_RATE_F_PER_SEC
        and used_f > 0
    )
    if not rate_ok:
        if fitted:
            seconds: float | None = float(tau_seconds)
        elif observed_seconds > 0:
            seconds = observed_seconds
        else:
            seconds = learned_seconds
        return round(desired, 2), None if seconds is None else round(float(seconds), 2)

    floor = 0.0 if learned_f is None else float(learned_f)
    if used_f <= floor + 0.05 or desired < floor:
        floor = desired
    elif desired > floor * PREDICT_COAST_SCALE_MAX:
        floor = desired / PREDICT_COAST_SCALE_MAX
    floor = min(EARLY_CUTOFF_MAX_F, max(0.0, floor))
    rate = float(rate_f_per_sec)
    if fitted and abs(predicted_coast_f(floor, float(tau_seconds), rate) - desired) <= 0.05:
        return round(floor, 2), round(float(tau_seconds), 2)
    if desired <= 0:
        fallback = float(tau_seconds) if fitted else learned_seconds
        return 0.0, None if fallback is None else round(float(fallback), 2)
    seconds = desired / rate
    if floor <= 0 or desired > floor * PREDICT_COAST_SCALE_MAX:
        floor = desired / PREDICT_COAST_SCALE_MAX
    if floor > desired:
        floor = desired
    if fitted and abs(predicted_coast_f(floor, float(tau_seconds), rate) - desired) <= 0.05:
        seconds = float(tau_seconds)
    return round(min(EARLY_CUTOFF_MAX_F, floor), 2), round(seconds, 2)


def seconds_to_target(
    temp_f: float,
    target_f: float,
    coast_f: float,
    rate_f_per_sec: float | None,
    learned_coast_f: float | None,
    learned_coast_seconds: float | None,
) -> float | None:
    """Seconds until the probe reaches the target, including residual heat.

    The powered gap is what the element still has to climb before the SSR
    opens. The tail is the learned coast duration, scaled when the live coast
    is larger than the measurement. Once the probe is already inside that
    coast, only the remaining rise at the current rate is left. Returns None
    when the probe is not rising.
    """

    if temp_f >= target_f:
        return 0.0
    if rate_f_per_sec is None or rate_f_per_sec < PREDICT_MIN_RATE_F_PER_SEC:
        return None
    gap = target_f - temp_f
    powered = gap - max(0.0, coast_f)
    if powered > 0:
        if learned_coast_f and learned_coast_seconds and learned_coast_f > 0:
            tail = float(learned_coast_seconds) * (max(0.0, coast_f) / float(learned_coast_f))
        elif coast_f > 0:
            tail = coast_f / rate_f_per_sec
        else:
            tail = 0.0
        seconds = powered / rate_f_per_sec + tail
    else:
        seconds = gap / rate_f_per_sec
    return min(PREDICT_MAX_HORIZON_SECONDS, max(0.0, seconds))


def seconds_to_cooldown(
    temp_f: float,
    rate_f_per_sec: float | None,
    *,
    learned_rate_f_per_min: float | None = None,
    floor_f: float = SAFE_TEMP_F,
) -> float | None:
    """Seconds for the probe to fall to ``floor_f``.

    After a run, ``floor_f`` is the safe-to-handle line. While a run is
    waiting on a lower setpoint, ``floor_f`` is that setpoint. A live falling
    slope is a straight line. A rise is not a cooldown. A flat window, or a
    window that is still too short, uses the learned °F/min from calibration.
    """

    if temp_f <= floor_f:
        return 0.0
    if rate_f_per_sec is not None and rate_f_per_sec <= -PREDICT_MIN_RATE_F_PER_SEC:
        seconds = (temp_f - floor_f) / -rate_f_per_sec
        return min(PREDICT_MAX_HORIZON_SECONDS, max(0.0, seconds))
    if rate_f_per_sec is not None and rate_f_per_sec >= PREDICT_MIN_RATE_F_PER_SEC:
        return None
    if learned_rate_f_per_min is not None and learned_rate_f_per_min > 0:
        seconds = (temp_f - floor_f) / (learned_rate_f_per_min / 60.0)
        return min(PREDICT_MAX_HORIZON_SECONDS, max(0.0, seconds))
    return None


def _grok_band(field_name: str) -> float:
    if field_name == "coast_rise_f":
        return GROK_RISE_BAND_F
    if field_name == "cooldown_f_per_min":
        return GROK_RATE_BAND_F_PER_MIN
    return GROK_RATE_BAND_F_PER_SEC


def _forecast_seconds(value: float | None) -> float | None:
    if value is None:
        return None
    return round(min(PREDICT_MAX_HORIZON_SECONDS, max(0.0, value)), 1)


def heater_should_be_on(
    temperature_f: float,
    target_f: float,
    currently_on: bool,
    *,
    early_cutoff_f: float,
    deadband_f: float = DEADBAND_F,
) -> bool:
    """Bang-bang decision for one resistive element on a zero-crossing SSR.

    The SSR can only open or close; it cannot throttle. Opening it does not
    stop the heating. The element sheath stays hot and keeps transferring
    heat into the water or mash for a noticeable time, often 10–60 seconds,
    depending on element mass, power, and volume. The probe lags that bulk
    temperature as well: it has its own thermal mass, and the pot is not
    perfectly mixed. Turning the element off only when the probe finally
    reads the setpoint therefore overshoots. That continued rise after the
    SSR is already open is normal.

    Power is removed early, ``early_cutoff_f`` degrees before the setpoint,
    so the heat still stored in the element carries the liquid the rest of
    the way. Power is applied again only when the probe falls through the
    bottom of a hysteresis band ``deadband_f`` degrees wide. Inside that
    band the previous state is kept, so a drifting reading cannot chatter
    the SSR.
    """

    cutoff_f = target_f - early_cutoff_f
    if temperature_f >= cutoff_f:
        return False
    if temperature_f <= cutoff_f - deadband_f:
        return True
    return currently_on


class ControllerError(Exception):
    def __init__(self, message: str, status: int = 400) -> None:
        super().__init__(message)
        self.message = message
        self.status = status


def _console_context(owner: weakref.ReferenceType) -> tuple[int | None, float | None]:
    """The open run and its clock. Cooldown keeps the same run after Stop."""

    controller = owner()
    if controller is None:
        return None, None
    if controller._run_id is not None:
        return controller._run_id, controller._elapsed
    if controller._cooldown_run_id is not None:
        return controller._cooldown_run_id, controller._cooldown_elapsed
    return None, None


class Controller:
    def __init__(
        self,
        store: Store,
        source: HardwareSource,
        display: Display | None = None,
    ) -> None:
        self.store = store
        self.source = source
        self._lock = threading.Lock()
        self._stop_loop = threading.Event()
        self._thread: threading.Thread | None = None
        self._shut_down = False
        self._display = NullDisplay()
        self._display_key: tuple[int, int] | None = None
        self._show_panel_step = True
        self._panel: object | None = None
        self._panel_key: tuple[int, ...] | None = None
        self._menu: SoftwareMenu | None = None
        self._menu_generation = 0
        self._menu_dirty = False
        self._menu_check_thread: threading.Thread | None = None
        self._hold_display = False
        # The dial paints this immediately. It is written to the database
        # once the knob has been still, so the screen is not waiting on disk.
        self._dial_target: int | None = None
        self._dial_dirty = False
        self._dial_moved_at = 0.0
        self._emergency: list[str] = []
        self._cabinet_temp: float | None = None
        self._cabinet_humidity: float | None = None
        self._climate_fault = False
        self._mode = "idle"
        self._run_id: int | None = None
        self._elapsed = 0.0
        self._since_sample = 0.0
        self._since_log = 0.0
        self._since_timeline = 0.0
        self._since_timeline_compact = 0.0
        self._cooldown_run_id: int | None = None
        self._cooldown_elapsed = 0.0
        self._cooldown_since_sample = 0.0
        self._cooldown_sensor: int | None = None
        # (cooldown elapsed seconds, control temperature) while heaters are off
        # after the run. The lower stop is read from the last 5 minutes of this.
        self._cooldown_window: list[tuple[float, float]] = []
        self._run_kind = "run"
        self._program: Program | None = None
        # Elapsed time when this run first latched hold. None until then, so
        # the heat-up does not count toward a timed hold.
        self._hold_started_at: float | None = None
        # Set just before an automatic close: "duration" or "max".
        self._program_end: str | None = None
        self._charge_gallons: float | None = None
        self._session: CalibrationSession | None = None
        self._suite: InitialHeatingSession | None = None
        self._test_review: dict | None = None
        self._run_model: ThermalModel | None = None
        # The model already saved when this calibration started. Later commits
        # fold the new measurements into this copy, not into their own output.
        self._calibration_prior: ThermalModel | None = None
        self._analysis_inbox: list[tuple[dict, object]] = []
        self._coast_f: float | None = None
        self._coast_seconds: float | None = None
        self._calibration_settled = False
        # Shown on the cooldown screen after a calibration saves its result.
        self._display_coast: float | None = None
        self._display_rate: float | None = None
        # Elapsed time when the current sustain pulse should end.
        self._pulse_until: float | None = None
        # Set once this run has already climbed above the sustain point, and
        # once a model run's projected coast has landed inside the hold band.
        # The approach has to stay off after the coast cutoff; a pulse before
        # that point heats the rest of the way and the stored heat overshoots.
        self._hold_ready = False
        # Elapsed time when the last hold pulse opened. The next pulse waits
        # out that coast. None once the coast has crested or aged out.
        self._hold_released_at: float | None = None
        # Degrees added to the setpoint when recent hold pulses crested short.
        # The probe is what has to reach the target; this only lets the next
        # pulse plan a higher crest when the coast model ran long.
        self._hold_bias_f = 0.0
        self._hold_peak_f: float | None = None
        self._hold_marked = False
        self._hold_mark_pending = False
        # The previous model decision's heat flag, so a hold pulse that just
        # opened can be told from one that is still on.
        self._model_was_heating = False
        # True after a climb shutoff until that projected coast is spent.
        self._climb_coasting = False
        # climb, coast, or hold. None until a ready model decides.
        self._run_step: str | None = None
        # Dial target used on the previous model decision, so a raised target
        # can leave the hold.
        self._last_target: float | None = None
        # Setpoint a run is waiting to fall to, after the operator lowers it.
        # None while the aim has not stepped down, and again once the probe
        # is inside the hold band. A dip in the reading does not set this.
        self._cool_to: float | None = None
        # Aim from the previous forecast, so a lowered setpoint can be told
        # from that dip.
        self._aim_seen: float | None = None
        self._heaters = [False] * SLOT_COUNT
        # (predict clock seconds, control temperature). The clock follows tick
        # time, including pause, so a test can advance it without sleeping.
        self._predict_clock = 0.0
        self._predict_samples: list[tuple[float, float]] = []
        # Control-probe samples for the rate shown on the dashboard. Kept apart
        # from the shutoff window so an idle screen can show it too.
        self._rate_clock = 0.0
        self._rate_samples: list[tuple[float, float]] = []
        # Samples since the SSR opened, cleared when an element turns back on.
        self._coast_curve: list[tuple[float, float]] = []
        # Temperature and slope at the moment the elements opened. The chart
        # spends this coast instead of starting a new one from the live slope.
        self._coast_open_temp: float | None = None
        self._coast_open_slope: float = 0.0
        # Coast and slope from the last shutoff decision, captured while the
        # sheath on-time is still the one that decision used.
        self._last_shutoff_coast = 0.0
        self._last_shutoff_rate: float | None = None
        self._heater_on_for = [0.0] * SLOT_COUNT
        # Where the sheath sits on the fixed coast crest. Heating and cooling
        # move it; opening the SSR does not put it back at zero.
        self._sheath_slope = 0.0
        # Off-time at the moment each SSR last closed. Infinity is a cold start.
        self._off_when_closed = [math.inf] * SLOT_COUNT
        # On-time at the moment each SSR last opened, so the sheath can cool
        # from hot instead of looking cold the instant the element turns off.
        self._on_when_opened = [0.0] * SLOT_COUNT
        # Powered time not yet written to the element-hour meters.
        self._heater_life_pending = [0.0] * SLOT_COUNT
        # Infinity means the off dwell is already satisfied, so the first
        # turn-on of a run is not delayed. A control-law turn-off sets this
        # back to zero. Pause and Stop leave it satisfied on purpose.
        self._heater_off_for = [math.inf] * SLOT_COUNT
        # The last control-law choice, before the minimum on and off times.
        self._decision: dict = {}
        self._desired = [False] * SLOT_COUNT
        # One heater change per tick(). Later seconds in that same call keep
        # the mask from the first edge so the SSR is not buzzed.
        self._tick_heater_lock: list[bool] | None = None
        # Heater mask already written to this run's log, so a later tick only
        # records a line when the SSR actually changes.
        self._logged_heaters: list[bool] | None = None
        self._console: ConsoleCapture | None = None
        self._install_console()
        if display is not None:
            self._display = display
            self._display_key = display_key(self.store.get_settings())
        # A previous process may have stopped mid-run. Close that record so
        # the next start is a new run, not a continuation of a dead one.
        self.store.close_open_runs()
        open_cooldown = self.store.claim_open_cooldown()
        if open_cooldown is not None:
            self._adopt_cooldown(open_cooldown)
        self._show_startup("Reading sensors")
        self._live_temps = self.source.read_temperatures(SLOT_COUNT)
        self._sample_climate()
        self._emergency = self._emergency_codes(self.store.get_settings())
        self._set_heaters([False] * SLOT_COUNT if self._emergency else self._heaters)
        if self._mode == "cooling":
            temp = self._cooldown_temp()
            if temp is not None and temp < SAFE_TEMP_F:
                self._complete_cooldown(self.store.get_settings())
        self._record_timeline_point()

    def _install_console(self) -> None:
        """Keep brewski log lines on the open run.

        A controller that has already been freed drops its handler here, so
        tests do not pile handlers onto the process logger.
        """

        log = logging.getLogger("brewski")
        # The service prints INFO. A test run often leaves the root logger at
        # WARNING, which would drop those lines before this handler saw them.
        # Leave a louder setting alone so DEBUG still reaches the console.
        if log.getEffectiveLevel() > logging.INFO:
            log.setLevel(logging.INFO)
        for existing in list(log.handlers):
            if isinstance(existing, ConsoleCapture) and not existing.alive():
                log.removeHandler(existing)
                existing.close()
        owner = weakref.ref(self)
        self._console = ConsoleCapture(self.store, lambda: _console_context(owner), owner)
        log.addHandler(self._console)

    def _detach_console(self) -> None:
        handler = getattr(self, "_console", None)
        if handler is None:
            return
        self._console = None
        log = logging.getLogger("brewski")
        log.removeHandler(handler)
        handler.close()

    def __del__(self) -> None:
        try:
            self._detach_console()
        except Exception:
            return

    def start_loop(self) -> None:
        if self._thread and self._thread.is_alive():
            return
        self._stop_loop.clear()
        self._sync_panel()
        self._thread = threading.Thread(target=self._loop, name="brewski-controller", daemon=True)
        self._thread.start()

    def shutdown(self) -> None:
        if self._shut_down:
            return
        self._shut_down = True
        self._stop_loop.set()
        if self._thread is not None:
            self._thread.join(timeout=5)
        with self._lock:
            if self._mode in ("running", "paused"):
                self._finish_run()
            if self._mode == "cooling":
                self._persist_cooldown()
            self._set_heaters([False] * SLOT_COUNT, release_off_dwell=True)
            self._flush_heater_life()
        self._close_display()
        self._close_panel()
        closer = getattr(self.source, "close", None)
        if closer is not None:
            closer()
        self._detach_console()

    def tick(self, dt: float) -> None:
        """Advance the run clock by ``dt`` seconds.

        Each second is evaluated so a long step still settles and logs. The
        heater may change only once in that step. A second edge would land
        on the SSR immediately, and a 1 second minimum would become a buzz.
        """

        self._apply_panel()
        self._flush_dial_target()
        remaining = min(max(0.0, float(dt)), MAX_TICK_SECONDS)
        with self._lock:
            self._tick_heater_lock = None
            while remaining > 0:
                slice_dt = min(1.0, remaining)
                self._tick(slice_dt)
                remaining -= slice_dt
            self._tick_heater_lock = None

    def status(self) -> dict:
        with self._lock:
            return self._status()

    def runs(self) -> dict:
        # The history query used to run while this lock was held, so a dashboard
        # refresh froze the sensor read, the LCD, and the chart samples.
        with self._lock:
            live = self._live_overlay()
            cooldown = self._cooldown_overlay()
            pending = list(self._heater_life_pending)
        listed = self.store.list_runs(live, cooldown)
        stored = self.store.heater_life_seconds()
        listed["stats"]["heater_life_seconds"] = [
            round(stored[index] + pending[index], 2) for index in range(SLOT_COUNT)
        ]
        return listed

    def timeline(self, start_ms: int, end_ms: int, max_points: int) -> dict:
        if int(end_ms) < int(start_ms):
            raise ControllerError("Timeline end is before the start", 400)
        capped = min(5000, max(50, int(max_points)))
        return self.store.timeline(int(start_ms), int(end_ms), capped)

    def run(
        self,
        run_id: int,
        *,
        include_logs: bool = True,
        include_samples: bool = True,
    ) -> dict:
        with self._lock:
            record = self.store.get_run(
                run_id,
                include_logs=include_logs,
                include_samples=include_samples,
            )
            if record is None:
                raise ControllerError("Run not found", 404)
            overlay = self._live_overlay()
            if overlay is not None and overlay["id"] == run_id:
                record["elapsed_seconds"] = round(self._elapsed, 2)
                record["status"] = self._mode
                # The database elapsed lags the in-memory clock between samples.
                if "samples" in record:
                    record["heater_on_seconds"] = heater_on_seconds(
                        record["samples"], record["elapsed_seconds"]
                    )
                else:
                    record["heater_on_seconds"] = self.store.heater_on_seconds_for(
                        run_id, record["elapsed_seconds"]
                    )
            cooldown = self._cooldown_overlay()
            if cooldown is not None and cooldown["id"] == run_id:
                record["cooldown_seconds"] = round(self._cooldown_elapsed, 2)
                record["cooldown_status"] = "open"
            return record

    def chart_samples(self, run_id: int, after_id: int = 0) -> dict:
        """Chart readings newer than ``after_id``. The run page appends these."""

        samples = self.store.chart_samples(run_id, after_id)
        if samples is None:
            raise ControllerError("Run not found", 404)
        return {"samples": samples}

    def review_window(
        self,
        run_id: int,
        *,
        limit: int,
        log_offset: int = 0,
        sample_offset: int = 0,
        from_elapsed: float | None = None,
        to_elapsed: float | None = None,
        clock: str = "run",
        events: list[str] | None = None,
        phase: str | None = None,
        tail: bool = False,
    ) -> dict:
        """One page of both logs for the run review."""

        if int(limit) not in REVIEW_PAGE_SIZES:
            raise ControllerError("Page size must be 10, 25, 50, or 100", 400)
        if (from_elapsed is None) != (to_elapsed is None):
            raise ControllerError("A custom window needs both ends", 400)
        if from_elapsed is not None and to_elapsed is not None:
            if from_elapsed < 0 or to_elapsed < 0 or from_elapsed > to_elapsed:
                raise ControllerError("Window end is before the start", 400)
            from_elapsed = round(float(from_elapsed), 2)
            to_elapsed = round(float(to_elapsed), 2)
        if clock not in REVIEW_CLOCKS:
            raise ControllerError("Clock must be run, cooldown, or both", 400)
        chosen = list(events or [])
        unknown = [name for name in chosen if name not in REVIEW_EVENTS]
        if unknown:
            raise ControllerError("Unknown control-log event", 400)
        phases: list[str] = []
        if phase:
            phases_for = phase_keys(phase)
            if phases_for is None:
                raise ControllerError("Unknown phase", 400)
            phases = list(phases_for)
        page = self.store.review_window(
            run_id,
            limit=int(limit),
            log_offset=max(0, int(log_offset)),
            sample_offset=max(0, int(sample_offset)),
            from_elapsed=from_elapsed,
            to_elapsed=to_elapsed,
            clock=clock,
            events=chosen,
            phases=phases,
            tail=bool(tail),
        )
        if page is None:
            raise ControllerError("Run not found", 404)
        return page

    def run_logs(self, run_id: int, after_id: int = 0) -> dict:
        """Control-log lines newer than ``after_id``. The run page appends these."""

        with self._lock:
            logs = self.store.run_logs(run_id, after_id)
        if logs is None:
            raise ControllerError("Run not found", 404)
        return {"logs": logs}

    def control_log_export(self, run_id: int) -> tuple[str, str]:
        """CSV text and a file name for the whole control log."""

        with self._lock:
            kind = self.store.run_kind(run_id)
            if kind is None:
                raise ControllerError("Run not found", 404)
            logs = self.store.run_logs(run_id)
        label = "calibration" if kind == "calibration" else "run"
        return control_log_csv(logs or []), f"brewski-{label}-{run_id}-log.csv"

    def run_export(self, run_id: int) -> tuple[bytes, str]:
        """Zip of the control-log CSV and the console output captured for this run."""

        with self._lock:
            kind = self.store.run_kind(run_id)
            if kind is None:
                raise ControllerError("Run not found", 404)
            logs = self.store.run_logs(run_id) or []
            lines = self.store.console_lines(run_id)
        label = "calibration" if kind == "calibration" else "run"
        stem = f"brewski-{label}-{run_id}"
        buffer = io.BytesIO()
        with zipfile.ZipFile(buffer, "w", compression=zipfile.ZIP_DEFLATED) as archive:
            archive.writestr(f"{stem}-log.csv", control_log_csv(logs))
            archive.writestr(f"{stem}-console.log", console_log_text(lines or []))
        return buffer.getvalue(), f"{stem}.zip"

    def update_settings(self, patch: dict) -> dict:
        with self._lock:
            self._write_pending_target()
            current = self.store.get_settings()
            try:
                updated = merge_settings(current, patch)
            except SettingsError as exc:
                raise ControllerError(str(exc), 400) from exc
            if self._mode in ("running", "paused") and shape_changed(current, updated):
                raise ControllerError(
                    "Heater, probe, and GPIO setup is locked while a run is open",
                    409,
                )
            self.store.save_settings(updated)
            self._dial_target = None
            self._dial_dirty = False
            self._apply_idle_outputs(updated)
            saved = self.store.get_settings().to_dict()
        self._refresh_display()
        return saved

    def replace_heater(self, slot: int) -> dict:
        """Zero one element's hour meter after it has been replaced."""

        with self._lock:
            if slot < 0 or slot >= SLOT_COUNT:
                raise ControllerError("Unknown heater", 404)
            if self._mode in ("running", "paused"):
                raise ControllerError("Replace the element after the run is stopped", 409)
            self._heater_life_pending[slot] = 0.0
            self._flush_heater_life()
            self.store.reset_heater_life(slot)
            return self._status()

    def clear_calibration(self) -> dict:
        """Forget the learned heating model so the next calibration starts over.

        Run history stays. A normal run stays locked until a new calibration
        saves a coast.
        """

        with self._lock:
            if self._mode in ("running", "paused"):
                raise ControllerError("Stop the run before clearing the calibration", 409)
            current = self.store.get_settings()
            self.store.save_settings(
                replace(
                    current,
                    learned_coast_f=None,
                    learned_coast_seconds=None,
                    learned_cooldown_f_per_min=None,
                    thermal_model=None,
                )
            )
            self._display_coast = None
            self._display_rate = None
            self._calibration_prior = None
            self._run_model = None
            self._coast_f = None
            self._coast_seconds = None
            status = self._status()
        self._refresh_display()
        return status

    def reset(self) -> dict:
        """Clear stored runs and return the controller to its first-boot state.

        Element hours are kept. Replace an element to start that meter over.
        """

        with self._lock:
            self._flush_heater_life()
            self._mode = "idle"
            self._run_id = None
            self._elapsed = 0.0
            self._since_sample = 0.0
            self._since_log = 0.0
            self._clear_coast()
            self._suite = None
            self._test_review = None
            self._clear_cooldown()
            self._clear_predict()
            self._clear_rate()
            self._set_heaters([False] * SLOT_COUNT, release_off_dwell=True)
            reset_source = getattr(self.source, "reset", None)
            if reset_source is not None:
                reset_source()
            self._set_heaters(self._heaters)
            self.store.reset()
            self._dial_target = None
            self._dial_dirty = False
            self._since_timeline = 0.0
            self._live_temps = self.source.read_temperatures(SLOT_COUNT)
            self._record_timeline_point()
            saved = self.store.get_settings().to_dict()
        self._refresh_display()
        return saved

    def update_status(self, *, fresh: bool = False) -> dict:
        return update_report(self.store.path.parent, fresh=fresh)

    def start_update(self) -> dict:
        """Hand the install to the root oneshot. The database is already saved."""

        with self._lock:
            if self._mode in ("running", "paused"):
                raise ControllerError("Stop the run before updating.", 409)
        current = self.update_status()
        if not current["apply_supported"]:
            raise ControllerError("This machine cannot install a Brewski update.", 400)
        if not current["available"]:
            if not current["reachable"]:
                raise ControllerError("GitHub could not be reached.", 502)
            raise ControllerError("No update is available.", 409)
        directory = self.store.path.parent
        write_status(
            phase="downloading",
            current=current["current"],
            latest=current["latest"] or "",
            error=None,
            ref=current.get("ref"),
            directory=directory,
        )
        self._hold_display = True
        self._close_display()
        try:
            start_apply_service()
        except (OSError, subprocess.CalledProcessError) as exc:
            self._hold_display = False
            self._refresh_display()
            raise ControllerError("Could not start the updater.", 500) from exc
        return self.update_status()

    def reboot(self) -> dict:
        """Reboot the Pi. Refused while a run is open or an update is installing."""

        with self._lock:
            if self._mode in ("running", "paused"):
                raise ControllerError("Stop the run before rebooting.", 409)
        phase = read_status(self.store.path.parent).get("phase")
        if phase in {"downloading", "building", "installing"}:
            raise ControllerError("Wait for the update to finish.", 409)
        try:
            request_reboot()
        except (OSError, subprocess.CalledProcessError) as exc:
            raise ControllerError("Could not reboot this Pi.", 500) from exc
        return {"rebooting": True}

    def start(self, patch: dict | None = None) -> dict:
        with self._lock:
            if self._test_review is not None:
                raise ControllerError("End the test result before starting a run", 409)
            if self._mode == "cooling":
                self._abandon_cooldown()
            elif self._mode != "idle":
                raise ControllerError("A run is already open", 409)
            patch = patch or {}
            program_keys = {"program_mode", "program_continuous", "program_duration_seconds"}
            if set(patch) - {"target_temp_f", "kind", "charge_gallons", "test", *program_keys}:
                raise ControllerError(
                    "Start only accepts target_temp_f, kind, charge_gallons, test, "
                    "and the hold program",
                    400,
                )
            kind = patch.get("kind", "run")
            if kind not in ("run", "calibration", "test"):
                raise ControllerError("kind must be run, calibration, or test", 400)
            if program_keys & set(patch) and kind != "run":
                raise ControllerError("A program is only for a run", 400)
            if kind == "test":
                if patch.get("test") != TEST_INITIAL_HEATING:
                    raise ControllerError("Unknown test", 400)
                if "charge_gallons" in patch or "target_temp_f" in patch:
                    raise ControllerError("A test does not take a target or a still size", 400)
            elif "test" in patch:
                raise ControllerError("test is only for a test run", 400)
            if kind != "calibration" and "charge_gallons" in patch:
                raise ControllerError("charge_gallons is only for a calibration", 400)
            if kind == "run" and self.store.get_settings().learned_coast_f is None:
                raise ControllerError("Calibrate the still before starting a run", 409)
            gallons = None
            if patch.get("charge_gallons") is not None:
                try:
                    gallons = charge_gallons(patch["charge_gallons"])
                except SettingsError as exc:
                    raise ControllerError(str(exc), 400) from exc
            self._write_pending_target()
            # A calibration aims at CALIBRATION_TEMP_F. A target in this
            # request would replace the setpoint the next real run uses.
            if kind != "calibration" and "target_temp_f" in patch:
                try:
                    updated = merge_settings(
                        self.store.get_settings(),
                        {"target_temp_f": patch["target_temp_f"]},
                    )
                except SettingsError as exc:
                    raise ControllerError(str(exc), 400) from exc
                self.store.save_settings(updated)
                self._dial_target = None
                self._dial_dirty = False
            if kind == "run" and program_keys & set(patch):
                try:
                    updated = merge_settings(
                        self.store.get_settings(),
                        {key: patch[key] for key in program_keys if key in patch},
                    )
                except SettingsError as exc:
                    raise ControllerError(str(exc), 400) from exc
                self.store.save_settings(updated)
            settings = self.store.get_settings()
            if kind == "calibration" and gallons is None:
                gallons = settings.charge_gallons
            if kind == "calibration":
                settings = self._scale_charge(settings, gallons)
            self._calibration_prior = (
                model_from_dict(settings.thermal_model) if kind == "calibration" else None
            )
            self._run_kind = kind
            self._charge_gallons = gallons
            self._program = None
            self._hold_started_at = None
            self._program_end = None
            self._session = (
                CalibrationSession(self._calibration_prior) if kind == "calibration" else None
            )
            self._suite = InitialHeatingSession() if kind == "test" else None
            self._run_model = (
                None if kind in ("calibration", "test") else model_from_dict(settings.thermal_model)
            )
            self._sheath_slope = 0.0
            self._coast_f = None
            self._coast_seconds = None
            self._calibration_settled = False
            self._display_coast = None
            self._display_rate = None
            self._pulse_until = None
            self._reset_model_run()
            self._last_target = float(self._target_value(settings))
            self._clear_predict()
            self._coast_curve.clear()
            self._live_temps = self.source.read_temperatures(SLOT_COUNT)
            self._sample_climate()
            self._emergency = self._emergency_codes(settings)
            if self._emergency:
                self._set_heaters([False] * SLOT_COUNT, release_off_dwell=True)
                raise ControllerError("Emergency stop is active", 409)
            if kind == "run":
                self._program = Program(
                    mode=settings.program_mode,
                    continuous=settings.program_continuous,
                    duration_seconds=settings.program_duration_seconds,
                )
            # Running before the first heater command so a calibration aims at
            # the learning temperature on that command, not at the saved run
            # setpoint. The first three seconds stay off.
            self._mode = "running"
            self._elapsed = 0.0
            self._since_sample = 0.0
            self._since_log = 0.0
            self._command_heaters(settings)
            run_settings = settings
            if kind == "calibration":
                run_settings = replace(settings, target_temp_f=int(CALIBRATION_TEMP_F))
            run = self.store.create_run(
                run_settings,
                kind=kind,
                charge_gallons=gallons,
                program=self._program,
            )
            self._run_id = int(run["id"])
            self._flush_hold_mark()
            if kind in ("calibration", "test"):
                self._add_mark(MARK_START)
            detail = self._control_detail(settings)
            prior = self._calibration_prior if kind == "calibration" else self._run_model
            if prior is not None:
                numbers = model_numbers(prior.to_dict())
                if numbers:
                    detail["model"] = numbers
            self._log(
                "start",
                start_message(
                    kind,
                    self._aim_temperature(settings),
                    None if prior is None else prior.to_dict(),
                    settings.learned_coast_f,
                ),
                detail,
            )
            self._record_sample(settings)
            self._record_control_log(settings)
            self._logged_heaters = self._heater_mask(settings)
            return self._status()

    def pause(self) -> dict:
        with self._lock:
            if self._mode != "running":
                raise ControllerError("There is no running run to pause", 409)
            if self._run_kind == "test":
                raise ControllerError("A test cannot be paused", 409)
            settings = self.store.get_settings()
            self._pulse_until = None
            # The hold latch does not survive a pause. Resume decides again
            # from the probe and the target.
            self._hold_ready = False
            self._hold_released_at = None
            self._hold_peak_f = None
            self._model_was_heating = False
            self._decision = {"path": "pause", "heat": False}
            self._desired = [False] * SLOT_COUNT
            self._set_heaters([False] * SLOT_COUNT, release_off_dwell=True)
            self._logged_heaters = self._heater_mask(settings)
            self._live_temps = self.source.read_temperatures(SLOT_COUNT)
            self._mode = "paused"
            self._record_sample(settings)
            self._record_control_log(settings)
            self.store.update_run(self._run_id, status="paused", elapsed_seconds=self._elapsed)
            self._flush_heater_life()
            logger.info("Run %s paused at %ss", self._run_id, round(self._elapsed, 1))
            return self._status()

    def resume(self) -> dict:
        with self._lock:
            if self._mode != "paused":
                raise ControllerError("There is no paused run to resume", 409)
            settings = self.store.get_settings()
            self._live_temps = self.source.read_temperatures(SLOT_COUNT)
            self._sample_climate()
            self._emergency = self._emergency_codes(settings)
            if self._emergency:
                self._set_heaters([False] * SLOT_COUNT, release_off_dwell=True)
                raise ControllerError("Emergency stop is active", 409)
            self._command_heaters(settings)
            self._mode = "running"
            self._log_output_changes(settings, None)
            self._record_sample(settings)
            self._record_control_log(settings)
            self.store.update_run(self._run_id, status="running", elapsed_seconds=self._elapsed)
            logger.info("Run %s resumed", self._run_id)
            return self._status()

    def stop(self) -> dict:
        with self._lock:
            if self._mode in ("running", "paused"):
                self._finish_run()
                return self._status()
            if not self._clear_test_review():
                raise ControllerError("There is no open run to stop", 409)
            status = self._status()
        self._refresh_display()
        return status

    def end_test(self) -> dict:
        """Clear a finished test result. A test that is still heating is left running."""

        with self._lock:
            if self._test_review is None:
                if self._mode in ("running", "paused") and self._suite is not None:
                    raise ControllerError("The test is still running", 409)
                raise ControllerError("There is no test result to end", 409)
            self._clear_test_review()
            status = self._status()
        self._refresh_display()
        return status

    def _clear_test_review(self) -> bool:
        """Caller holds ``self._lock``. True when a result was on screen."""

        if self._test_review is None:
            return False
        self._test_review = None
        return True

    def _show_startup(self, step: str) -> None:
        self._display.write(startup_lines(step))

    def _refresh_display(self) -> None:
        if self._hold_display:
            phase = read_status(self.store.path.parent).get("phase")
            if phase != "failed":
                return
            self._hold_display = False
        with self._lock:
            self._drop_menu_if_blocked()
            settings = self.store.get_settings()
            key = display_key(settings)
            if self._menu is not None and key is not None:
                address, hostname = "", ""
                if self._menu.screen == "networking":
                    try:
                        address, hostname = display_identity()
                    except Exception:
                        logger.exception("Could not read the network address")
                        address, hostname = "No address", "—"
                if self._menu.screen == "hold" and not self._menu.editing:
                    self._load_menu_program()
                revision = installed_revision() if self._menu.screen == "about" else None
                lines = self._menu.lines(
                    __version__,
                    address=address,
                    hostname=hostname,
                    update_source=settings.update_source,
                    revision=revision,
                )
                led_state = self._menu.leds()
            else:
                lines = self._panel_lines(settings) if key is not None else None
                led_state = indicator_leds(
                    self._mode,
                    emergency=bool(self._emergency),
                    review=self._test_review is not None,
                )
        self._sync_panel()
        if self._panel is not None:
            self._panel.set_leds(*led_state)  # type: ignore[attr-defined]
        if key != self._display_key:
            self._display.clear()
            self._display.close()
            if self._hold_display:
                self._display = NullDisplay()
                self._display_key = None
                return
            self._display = open_display(settings) if key is not None else NullDisplay()
            self._display_key = key
        if self._hold_display or lines is None:
            return
        self._display.write(lines)

    def _close_display(self) -> None:
        self._display.clear()
        self._display.close()
        self._display = NullDisplay()
        self._display_key = None

    def _calibration_lcd(self) -> dict:
        """Which calibration step the panel should name, and the number for it."""

        if self._mode == "cooling" and self._display_coast is not None:
            return {"peak": self._display_coast, "rate": self._display_rate}
        session = self._session
        if session is None or self._run_kind != "calibration" or self._mode not in ("running", "paused"):
            return {}
        return {
            "step": session.phase,
            "rise": session.live_rise,
            "peak": session.model.coast_rise_f,
            "rate": session.live_rate if session.live_rate is not None else session.model.cooldown_f_per_min,
        }

    def _panel_lines(self, settings: Settings) -> list[str]:
        probes: list[tuple[str, float | None]] = []
        for index, channel in enumerate(settings.sensors):
            if not channel.enabled or index >= len(self._live_temps):
                continue
            value = self._live_temps[index]
            probes.append((channel.name, None if value is None else float(value)))
        heaters = [
            (
                channel.enabled,
                bool(self._heaters[index]) if index < len(self._heaters) else False,
            )
            for index, channel in enumerate(settings.heaters)
        ]
        elapsed = self._cooldown_elapsed if self._mode == "cooling" else self._elapsed
        code = self._emergency[0] if self._emergency else None
        if not code and self._test_review is not None and self._mode not in ("running", "paused"):
            return suite_result_lines(self._test_review)
        if (
            not code
            and self._suite is not None
            and self._run_kind == "test"
            and self._mode in ("running", "paused")
        ):
            return suite_run_lines(self._suite.phase, self._suite.phase_elapsed(), probes, heaters)
        lcd = self._calibration_lcd()
        forecast = self._forecast(settings)
        if forecast["seconds_to_target"] is not None:
            eta_seconds: float | None = forecast["seconds_to_target"]
            eta_kind: str | None = "target"
        elif forecast["seconds_to_cooldown"] is not None:
            eta_seconds = forecast["seconds_to_cooldown"]
            eta_kind = "cool"
        else:
            eta_seconds = None
            eta_kind = None
        view = self._program_status(settings)["program"]
        hold_remaining = None
        if (
            self._mode in ("running", "paused")
            and self._run_kind == "run"
            and view["state"] == "holding"
            and view["remaining_seconds"] is not None
        ):
            hold_remaining = view["remaining_seconds"]
        return status_lines(
            mode=self._mode,
            elapsed_seconds=elapsed,
            target_f=self._aim_temperature(settings),
            probes=probes,
            heaters=heaters,
            calibrating=self._run_kind == "calibration" and self._mode in ("running", "paused"),
            needs_calibration=settings.learned_coast_f is None and self._mode == "idle",
            emergency_code=code,
            cabinet_temp_f=self._cabinet_temp,
            cabinet_limit_f=settings.cabinet_limit_f,
            cabinet_fault=code == "E02",
            calibration_step=lcd.get("step"),
            calibration_rise_f=lcd.get("rise"),
            calibration_peak_f=lcd.get("peak"),
            calibration_rate_f=lcd.get("rate"),
            eta_seconds=eta_seconds,
            eta_kind=eta_kind,
            program_mode=settings.program_mode,
            hold_remaining_seconds=hold_remaining,
        )

    def _loop(self) -> None:
        last = time.monotonic()
        since_control = 1.0
        while not self._stop_loop.is_set():
            now = time.monotonic()
            dt = now - last
            last = now
            since_control += dt
            try:
                moved = self._apply_panel()
            except Exception:
                logger.exception("Panel update failed")
                moved = False
            if self._dial_dirty and now - self._dial_moved_at >= 0.15:
                try:
                    self._flush_dial_target()
                except Exception:
                    logger.exception("Could not save the target")
            if since_control >= 1.0:
                try:
                    self.tick(since_control)
                except Exception:
                    logger.exception("Controller tick failed")
                since_control = 0.0
                try:
                    self._refresh_display()
                except Exception:
                    logger.exception("LCD refresh failed")
            # While the knob is moving, paint the next target immediately.
            # Sleeping here is what left the number trailing the dial.
            if not moved:
                self._stop_loop.wait(0.02)

    def _tick(self, dt: float) -> None:
        self._drain_analysis()
        settings = self.store.get_settings()
        stepper = getattr(self.source, "step", None)
        if stepper is not None:
            stepper(dt)
        self._live_temps = self.source.read_temperatures(SLOT_COUNT)
        self._sample_climate()
        self._note_rate(dt)
        self._emergency = self._emergency_codes(settings)
        try:
            self._note_timeline(dt, settings)
        except Exception:
            logger.exception("Timeline sample was not saved")
        if self._mode in ("running", "paused", "cooling"):
            if self._current_control(settings) is None:
                self._predict_samples.clear()
            else:
                self._note_predict(dt)
        if self._emergency:
            if self._mode in ("running", "paused"):
                self._finish_run()
            self._set_heaters([False] * SLOT_COUNT, release_off_dwell=True)
            return
        if self._mode != "running":
            self._apply_idle_outputs(settings)
            if self._mode == "cooling":
                self._tick_cooldown(dt, settings)
            elif self._mode == "paused":
                if self._close_for_program(settings):
                    return
                self._advance_cooldown_clock(dt, settings)
                self._note_control_log(dt, settings)
            return
        self._elapsed += dt
        if self._close_for_program(settings):
            return
        self._note_heater_dwell(dt)
        phase_before = self._active_phase()
        self._advance_calibration(settings)
        self._advance_suite(settings)
        if self._mode != "running":
            return
        self._step_sheath(dt, settings)
        self._command_heaters(settings)
        self._note_hold_clock()
        if self._close_for_program(settings):
            return
        self._log_output_changes(settings, phase_before)
        if self._mode != "running":
            return
        self._advance_cooldown_clock(dt, settings)
        self._note_control_log(dt, settings)
        self._since_sample += dt
        while self._since_sample >= SAMPLE_INTERVAL_SECONDS:
            self._since_sample -= SAMPLE_INTERVAL_SECONDS
            self._record_sample(settings)
            self.store.update_run(self._run_id, elapsed_seconds=self._elapsed)

    def _finish_run(self) -> None:
        settings = self.store.get_settings()
        suite = self._suite
        if suite is not None:
            if not suite.finished:
                found = self._current_control(settings)
                if found is not None:
                    temp = float(found[1])
                elif suite.samples:
                    temp = suite.samples[-1][1]
                else:
                    temp = 0.0
                suite.abort(self._elapsed, temp)
                for name in suite.pending_marks:
                    self._add_mark(name)
            self._publish_test(suite)
            self._suite = None
            self._run_kind = "run"
        session = self._session
        end_reason = self._program_end
        completed = (session is not None and session.finished) or end_reason in {"duration", "max"}
        if session is not None:
            if session.model.coast_rise_f is not None or session.model.linear_rate_f_per_sec is not None:
                self._commit_model(settings)
            saved = self.store.get_settings()
            self._display_coast = saved.learned_coast_f
            self._display_rate = saved.learned_cooldown_f_per_min
            self._calibration_settled = session.reached_target
            self._session = None
            self._calibration_prior = None
        elif self._run_kind == "calibration" and self._coast_f is not None:
            self._display_coast = self._coast_f
        self._session = None
        self._run_model = None
        self._pulse_until = None
        self._reset_model_run()
        self._flush_heater_life()
        self._decision = {"path": "complete" if completed else "stop", "heat": False}
        self._desired = [False] * SLOT_COUNT
        self._set_heaters([False] * SLOT_COUNT, release_off_dwell=True)
        self._logged_heaters = [False] * SLOT_COUNT
        self._live_temps = self.source.read_temperatures(SLOT_COUNT)
        if self._run_id is not None:
            self._record_sample(settings)
            self._record_control_log(settings)
            closing = "complete" if completed else "stopped"
            fields: dict[str, object] = {
                "status": closing,
                "elapsed_seconds": self._elapsed,
                "ended_at": utc_now(),
            }
            if end_reason:
                fields["program_end"] = end_reason
            self.store.update_run(self._run_id, **fields)
            logger.info("Run %s %s at %ss", self._run_id, closing, round(self._elapsed, 1))
            self._begin_cooldown(self._run_id)
        self._run_id = None
        self._elapsed = 0.0
        self._since_sample = 0.0
        self._program = None
        self._hold_started_at = None
        self._program_end = None
        if self._mode != "cooling":
            self._mode = "idle"

    def _note_hold_clock(self) -> None:
        """Start the hold timer the first time this run is holding.

        Caller holds ``self._lock``. A later sag does not move the start.
        """

        if self._program is None or self._run_kind != "run" or self._mode != "running":
            return
        if self._hold_started_at is None and self._hold_ready:
            self._hold_started_at = self._elapsed

    def _close_for_program(self, settings: Settings) -> bool:
        """Complete the run when the hold timer or the emergency cap is due.

        Caller holds ``self._lock``. True when the run was closed.
        """

        if self._mode not in ("running", "paused") or self._run_id is None:
            return False
        program = self._program if self._program is not None else Program(continuous=True)
        hold = None
        if self._program is not None and self._hold_started_at is not None:
            hold = max(0.0, self._elapsed - self._hold_started_at)
        reason = program_end(
            program,
            elapsed_seconds=self._elapsed,
            hold_seconds=hold,
            max_program_hours=settings.max_program_hours,
        )
        if reason is None:
            return False
        self._program_end = reason
        self._finish_run()
        return True

    def _program_status(self, settings: Settings) -> dict:
        """Armed program while idle, and the open program while a run is going."""

        active = (
            self._mode in ("running", "paused")
            and self._run_kind == "run"
            and self._program is not None
        )
        program = self._program if active and self._program is not None else Program(
            mode=settings.program_mode,
            continuous=settings.program_continuous,
            duration_seconds=settings.program_duration_seconds,
        )
        hold = None
        if active and self._hold_started_at is not None:
            hold = max(0.0, self._elapsed - self._hold_started_at)
        if not active:
            state = "idle"
        elif self._mode == "paused":
            state = "paused"
        elif hold is not None:
            state = "holding"
        else:
            state = "heating"
        remaining = None
        if program.mode == "hold" and not program.continuous and hold is not None:
            remaining = max(0.0, program.duration_seconds - hold)
        cap_left = None
        if self._mode in ("running", "paused") and self._run_id is not None:
            cap_left = max(0.0, settings.max_program_hours * 3600 - self._elapsed)
        return {
            "program": {
                "mode": program.mode,
                "continuous": program.continuous,
                "duration_seconds": program.duration_seconds,
                "state": state,
                "hold_seconds": None if hold is None else round(hold, 1),
                "remaining_seconds": None if remaining is None else round(remaining, 1),
            },
            "max_program_hours": settings.max_program_hours,
            "max_program_remaining_seconds": None if cap_left is None else round(cap_left, 1),
        }

    def _begin_cooldown(self, run_id: int) -> None:
        settings = self.store.get_settings()
        if self._cooldown_run_id is None:
            self._advance_cooldown_clock(0, settings)
        if self._cooldown_run_id is None:
            self._open_cooldown_if_hot(settings)
        if self._cooldown_run_id is None:
            return
        self._mode = "cooling"
        self._record_cooldown_sample(settings)
        self._record_control_log(settings)
        self._persist_cooldown()
        logger.info("Run %s cooling; cooldown clock at %ss", run_id, round(self._cooldown_elapsed, 1))

    def _advance_cooldown_clock(self, dt: float, settings: Settings) -> None:
        """Count time after the control probe first reaches the target.

        The lower stop is not decided here. Holding at the target, or pausing,
        still belongs to the cooldown, but the temperature can only "stop"
        once the run is over and the heaters are off.
        """

        if self._mode == "cooling" or self._run_id is None:
            return
        if self._cooldown_run_id is None:
            found = self._current_control(settings)
            if found is None:
                return
            index, temp = found
            aim = self._aim_temperature(settings)
            if temp < aim:
                return
            self._cooldown_run_id = self._run_id
            self._cooldown_sensor = index
            self._cooldown_elapsed = 0.0
            self._cooldown_since_sample = 0.0
            self.store.update_run(
                self._run_id,
                cooldown_status="open",
                cooldown_seconds=0,
                cooldown_baseline_f=aim,
                cooldown_sensor_index=index,
            )
            logger.info(
                "Run %s reached %s°F; cooldown timing started",
                self._run_id,
                aim,
            )
        self._cooldown_elapsed += dt
        self._cooldown_since_sample += dt
        while self._cooldown_since_sample >= SAMPLE_INTERVAL_SECONDS:
            self._cooldown_since_sample -= SAMPLE_INTERVAL_SECONDS
            self._persist_cooldown()

    def _adopt_cooldown(self, run: dict) -> None:
        sensor = run.get("cooldown_sensor_index")
        if sensor is None:
            self.store.update_run(int(run["id"]), cooldown_status="abandoned")
            return
        self._mode = "cooling"
        self._cooldown_run_id = int(run["id"])
        self._cooldown_elapsed = float(run.get("cooldown_seconds") or 0)
        self._cooldown_since_sample = 0.0
        self._cooldown_sensor = int(sensor)
        self._cooldown_window = []

    def _tick_cooldown(self, dt: float, settings: Settings) -> None:
        if self._cooldown_run_id is None or self._cooldown_sensor is None:
            self._clear_cooldown()
            return
        self._cooldown_elapsed += dt
        self._cooldown_since_sample += dt
        current = self._cooldown_temp()
        if current is not None and current < SAFE_TEMP_F:
            self._complete_cooldown(settings)
            return
        self._note_control_log(dt, settings)
        while self._cooldown_since_sample >= SAMPLE_INTERVAL_SECONDS:
            self._cooldown_since_sample -= SAMPLE_INTERVAL_SECONDS
            self._record_cooldown_sample(settings)
        self._persist_cooldown()

    def _open_cooldown_if_hot(self, settings: Settings) -> None:
        """Start a cooldown when a run stops above 100°F without having reached its aim."""

        if self._run_id is None or self._cooldown_run_id is not None:
            return
        found = self._current_control(settings)
        if found is None:
            return
        index, temp = found
        if temp <= SAFE_TEMP_F:
            return
        self._cooldown_run_id = self._run_id
        self._cooldown_sensor = index
        self._cooldown_elapsed = 0.0
        self._cooldown_since_sample = 0.0
        self.store.update_run(
            self._run_id,
            cooldown_status="open",
            cooldown_seconds=0,
            cooldown_baseline_f=round(temp, 2),
            cooldown_sensor_index=index,
        )
        logger.info("Run %s cooling from %s°F", self._run_id, round(temp, 1))

    def _complete_cooldown(self, settings: Settings) -> None:
        run_id = self._cooldown_run_id
        elapsed = self._cooldown_elapsed
        self._record_cooldown_sample(settings)
        self._record_control_log(settings)
        self.store.update_run(
            run_id,
            cooldown_status="complete",
            cooldown_seconds=round(elapsed, 2),
            cooldown_ended_at=utc_now(),
        )
        logger.info("Run %s cooled in %ss", run_id, round(elapsed, 1))
        self._clear_cooldown()

    def _abandon_cooldown(self) -> None:
        if self._cooldown_run_id is None:
            self._clear_cooldown()
            return
        run_id = self._cooldown_run_id
        self.store.update_run(
            run_id,
            cooldown_status="interrupted",
            cooldown_seconds=round(self._cooldown_elapsed, 2),
        )
        logger.info("Run %s cooldown interrupted at %ss", run_id, round(self._cooldown_elapsed, 1))
        self._clear_cooldown()

    def _persist_cooldown(self) -> None:
        if self._cooldown_run_id is None:
            return
        self.store.update_run(
            self._cooldown_run_id,
            cooldown_seconds=round(self._cooldown_elapsed, 2),
        )

    def _record_cooldown_sample(self, settings: Settings) -> None:
        if self._cooldown_run_id is None:
            return
        temps = self._sample_temps()
        self.store.add_sample(
            run_id=self._cooldown_run_id,
            elapsed_seconds=round(self._cooldown_elapsed, 2),
            temps_f=temps,
            heaters_on=[False] * SLOT_COUNT,
            target_temp_f=(
                CALIBRATION_TEMP_F
                if self._run_kind == "calibration"
                else float(settings.target_temp_f)
            ),
            phase="cooldown",
        )
        self._log_forecast(settings)

    def _clear_cooldown(self) -> None:
        self._cooldown_run_id = None
        self._cooldown_elapsed = 0.0
        self._cooldown_since_sample = 0.0
        self._cooldown_sensor = None
        self._cooldown_window = []
        self._display_coast = None
        self._display_rate = None
        if self._mode == "cooling":
            self._mode = "idle"

    def _cooldown_temp(self) -> float | None:
        index = self._cooldown_sensor
        if index is None or index >= len(self._live_temps):
            return None
        return float(self._live_temps[index])

    def _cooldown_overlay(self) -> dict | None:
        if self._mode != "cooling" or self._cooldown_run_id is None:
            return None
        return {
            "id": self._cooldown_run_id,
            "cooldown_seconds": self._cooldown_elapsed,
            "cooldown_status": "open",
        }

    def _apply_idle_outputs(self, settings: Settings) -> None:
        if self._mode == "running":
            return
        self._set_heaters([False] * SLOT_COUNT, release_off_dwell=True)

    def _note_heater_dwell(self, dt: float) -> None:
        for index in range(SLOT_COUNT):
            if self._heaters[index]:
                self._heater_on_for[index] += dt
                self._heater_life_pending[index] += dt
            else:
                self._heater_off_for[index] += dt
        # A crash should not drop more than a few seconds of element life.
        if max(self._heater_life_pending) >= 5.0:
            self._flush_heater_life()

    def _flush_heater_life(self) -> None:
        pending = self._heater_life_pending
        if not any(pending):
            return
        self.store.add_heater_life(pending)
        self._heater_life_pending = [0.0] * SLOT_COUNT

    def _life_seconds(self) -> list[float]:
        stored = self.store.heater_life_seconds()
        return [
            round(stored[index] + self._heater_life_pending[index], 2)
            for index in range(SLOT_COUNT)
        ]

    def _command_heaters(self, settings: Settings) -> None:
        """Apply the temperature decision, then the minimum on and off times.

        The dwells are longer than an AC cycle, so a zero-crossing SSR is
        not asked to change state on every reading. Pause and Stop skip the
        dwell and open the SSR immediately.
        """

        desired = self._decide(settings, self._live_temps)
        self._desired = list(desired)
        min_on = settings.heater_min_on_seconds
        min_off = settings.heater_min_off_seconds
        states = []
        for index in range(SLOT_COUNT):
            enabled = settings.heaters[index].enabled
            if not enabled:
                states.append(False)
                continue
            # Finish an on-dwell even if the probe has already reached the
            # early cutoff. The matching off-dwell blocks the turn back on.
            if self._heaters[index] and not desired[index] and self._heater_on_for[index] < min_on:
                states.append(True)
                continue
            if (
                not self._heaters[index]
                and desired[index]
                and self._heater_off_for[index] < min_off
            ):
                states.append(False)
                continue
            states.append(bool(desired[index]))
        if self._tick_heater_lock is not None:
            states = list(self._tick_heater_lock)
        elif states != self._heaters:
            self._tick_heater_lock = list(states)
        self._set_heaters(states)
        self._note_coast_curve(settings)

    def _set_heaters(self, states: list[bool], *, release_off_dwell: bool = False) -> None:
        requested = [bool(on) for on in states[:SLOT_COUNT]]
        while len(requested) < SLOT_COUNT:
            requested.append(False)
        previous = list(self._heaters)
        while len(previous) < SLOT_COUNT:
            previous.append(False)
        self._heaters = requested
        for index, on in enumerate(self._heaters):
            if on:
                if not previous[index]:
                    self._off_when_closed[index] = self._heater_off_for[index]
                self._heater_off_for[index] = math.inf
            else:
                if previous[index]:
                    self._on_when_opened[index] = self._heater_on_for[index]
                self._heater_on_for[index] = 0.0
                # Only the transition into off starts the dwell. Holding an
                # already-open SSR does not reset the timer. Pause and Stop
                # release it so the next Start or Resume is not delayed.
                if previous[index] or release_off_dwell:
                    self._heater_off_for[index] = math.inf if release_off_dwell else 0.0
        self.source.set_heaters(self._heaters)

    def _scale_charge(self, settings: Settings, gallons: float | None) -> Settings:
        """Scale a remembered model when this calibration uses a different volume."""

        updates: dict = {}
        scaled = scaled_cutoff(settings.learned_coast_f, settings.charge_gallons, gallons)
        if scaled is not None:
            updates["learned_coast_f"] = scaled
        scaled_cool = scaled_rate(
            settings.learned_cooldown_f_per_min, settings.charge_gallons, gallons
        )
        if scaled_cool is not None:
            updates["learned_cooldown_f_per_min"] = scaled_cool
        grown = scale_model(model_from_dict(settings.thermal_model), settings.charge_gallons, gallons)
        if grown.to_dict() != model_from_dict(settings.thermal_model).to_dict():
            updates["thermal_model"] = grown.to_dict()
            if grown.coast_rise_f is not None:
                updates["learned_coast_f"] = min(EARLY_CUTOFF_MAX_F, max(0.0, grown.coast_rise_f))
            if grown.coast_seconds is not None:
                updates["learned_coast_seconds"] = grown.coast_seconds
            if grown.cooldown_f_per_min is not None:
                updates["learned_cooldown_f_per_min"] = grown.cooldown_f_per_min
        if not updates:
            return settings
        settings = replace(settings, **updates)
        self.store.save_settings(settings)
        return settings

    def _advance_calibration(self, settings: Settings) -> None:
        """Move the calibration one reading, then let the heater command follow."""

        session = self._session
        if session is None or self._run_kind != "calibration" or self._mode != "running":
            return
        found = self._current_control(settings)
        if found is None:
            return
        session.observe(
            self._elapsed,
            found[1],
            self._pulse_on_seconds(settings),
            settings.heater_min_on_seconds,
            self._hold_off_seconds(settings),
            settings.heater_min_off_seconds,
        )
        for name in session.pending_marks:
            self._add_mark(name)
        # The session still prepares stage analysis. This run does not send it.
        if session.reached_target:
            self._calibration_settled = True
        if session.commit:
            self._commit_model(settings)
        if session.finished:
            self._finish_run()

    def _advance_suite(self, settings: Settings) -> None:
        """Move an Initial Heating test one reading."""

        suite = self._suite
        if suite is None or self._run_kind != "test" or self._mode != "running":
            return
        found = self._current_control(settings)
        if found is None:
            return
        suite.observe(self._elapsed, found[1])
        for name in suite.pending_marks:
            self._add_mark(name)
        if suite.finished:
            self._finish_run()

    def _publish_test(self, suite: InitialHeatingSession) -> None:
        payload = suite.payload(review=True, run_id=self._run_id)
        self._test_review = payload
        self._log("test", suite_result_message(payload), payload)

    def _active_phase(self) -> str | None:
        if self._session is not None:
            return self._session.phase
        if self._suite is not None:
            return self._suite.phase
        return self._published_run_step()

    def _published_run_step(self) -> str | None:
        """Climb, coast, or hold while a ready model is running the heaters."""

        if self._mode not in ("running", "paused") or self._run_kind != "run":
            return None
        if self._session is not None or self._suite is not None:
            return None
        if self._run_model is None or not self._run_model.ready():
            return None
        return self._run_step

    def _status_predicted_crest(self) -> float | None:
        """The crest the live decision is using, for the dashboard sentence."""

        if self._session is not None and self._session.predicted_crest is not None:
            return round(self._session.predicted_crest, 1)
        if self._published_run_step() is None:
            return None
        crest = self._decision.get("predicted_crest_f")
        if crest is None:
            return None
        return round(float(crest), 1)

    def _test_payload(self) -> dict | None:
        if self._suite is not None and self._mode in ("running", "paused"):
            return self._suite.payload(review=False, run_id=self._run_id)
        if self._test_review is not None:
            return dict(self._test_review)
        return None

    def _step_sheath(self, dt: float, settings: Settings) -> None:
        """Move the crest entry for a normal run. Calibration steps its own."""

        model = self._run_model
        if self._session is not None or model is None or not model.ready():
            return
        self._sheath_slope = step_sheath_slope(
            model,
            self._sheath_slope,
            heating=self._elements_on(settings),
            dt=dt,
        )

    def _pulse_on_seconds(self, settings: Settings) -> float:
        """How long the enabled elements that are on have been on."""

        ons = [
            self._heater_on_for[index]
            for index in range(SLOT_COUNT)
            if settings.heaters[index].enabled and self._heaters[index]
        ]
        if not ons:
            return 0.0
        return max(ons)

    def _opened_on_seconds(self, settings: Settings) -> float:
        """How long the elements had been on when they last opened."""

        opened = [
            self._on_when_opened[index]
            for index in range(SLOT_COUNT)
            if settings.heaters[index].enabled
        ]
        if not opened:
            return 0.0
        return max(opened)

    def _hold_off_seconds(self, settings: Settings) -> float:
        """Seconds the enabled elements have been off.

        Infinity means the off dwell is already satisfied, including the
        start of a run. Zero while an element is on.
        """

        if self._elements_on(settings):
            return 0.0
        shortest = math.inf
        saw = False
        for index in range(SLOT_COUNT):
            if not settings.heaters[index].enabled or self._heaters[index]:
                continue
            saw = True
            off = self._heater_off_for[index]
            if math.isfinite(off):
                shortest = min(shortest, off)
        if not saw:
            return 0.0
        return shortest

    def _coast_off_seconds(self, settings: Settings) -> float:
        """How long the enabled elements have been off since they opened."""

        offs = []
        for index in range(SLOT_COUNT):
            if not settings.heaters[index].enabled or self._heaters[index]:
                continue
            off = self._heater_off_for[index]
            if math.isfinite(off):
                offs.append(off)
        if not offs:
            return 0.0
        return max(offs)

    def _add_mark(self, name: str) -> None:
        if self._run_id is None:
            return
        self.store.add_mark(self._run_id, name, self._elapsed)

    def _commit_model(self, settings: Settings) -> None:
        """Write the model learned so far. Missing stages do not erase a previous one."""

        session = self._session
        if session is None:
            return
        prior = self._calibration_prior if self._calibration_prior is not None else ThermalModel()
        model = blend_model(prior, session.model)
        current = self.store.get_settings()
        coast = current.learned_coast_f
        seconds = current.learned_coast_seconds
        rate = current.learned_cooldown_f_per_min
        if model.coast_rise_f is not None:
            coast = round(max(0.0, model.coast_rise_f), 2)
            self._coast_f = coast
        if model.coast_seconds is not None:
            seconds = round(max(0.0, model.coast_seconds), 2)
            self._coast_seconds = seconds
        if model.cooldown_f_per_min is not None:
            rate = round(min(COOLDOWN_RATE_MAX, max(0.0, model.cooldown_f_per_min)), 2)
        learned = replace(
            current,
            learned_coast_f=coast,
            learned_coast_seconds=seconds,
            learned_cooldown_f_per_min=rate,
            charge_gallons=self._charge_gallons if self._charge_gallons is not None else current.charge_gallons,
            thermal_model=model.to_dict(),
        )
        self.store.save_settings(learned)
        if self._run_id is not None:
            import json

            self.store.update_run(
                self._run_id,
                coast_f=coast,
                coast_seconds=seconds,
                cooldown_f_per_min=rate,
                calibration_settled=1 if self._calibration_settled else 0,
                thermal_model=json.dumps(model.to_dict()),
            )
        self._log(
            "model",
            model_message(model.to_dict()),
            {
                "model": model.to_dict(),
                "coast_f": coast,
                "coast_seconds": seconds,
                "cooldown_f_per_min": rate,
            },
        )

    def _queue_analysis(self, item: dict) -> None:
        """Ask Grok about one stage. The loop keeps the local fit until it answers."""

        run_id = self._run_id
        if run_id is None:
            return
        kind = str(item.get("kind") or "")
        local = item.get("local")
        if not analysis.api_key():
            self._record_analysis(run_id, kind, local, None, False)
            return
        samples = item.get("samples") or []

        def finish(value: object) -> None:
            self._accept_analysis(run_id, item, value)

        if analysis.inline_analysis():
            finish(analysis.analyze_rate(samples, kind))
            return

        def work() -> None:
            value = analysis.analyze_rate(samples, kind)
            with self._lock:
                self._analysis_inbox.append(({"run_id": run_id, **item}, value))

        threading.Thread(target=work, name="brewski-analysis", daemon=True).start()

    def _queue_full_analysis(self, session: CalibrationSession) -> None:
        """One pass over the finished calibration, applied to the next run's model."""

        run_id = self._run_id
        if run_id is None or not analysis.api_key():
            if run_id is not None:
                self._record_analysis(run_id, "full", None, None, False)
            return
        samples = [[round(stamp, 2), round(reading, 3)] for stamp, reading in session.samples]
        local = session.model.to_dict()

        def finish(value: object) -> None:
            self._revise_saved_model(run_id, local, value if isinstance(value, dict) else None)

        if analysis.inline_analysis():
            finish(analysis.analyze_model(samples, local))
            return

        def work() -> None:
            value = analysis.analyze_model(samples, local)
            with self._lock:
                self._analysis_inbox.append(
                    ({"run_id": run_id, "kind": "full", "local_model": local}, value)
                )

        threading.Thread(target=work, name="brewski-analysis", daemon=True).start()

    def _drain_analysis(self) -> None:
        inbox = self._analysis_inbox
        if not inbox:
            return
        self._analysis_inbox = []
        for item, value in inbox:
            kind = str(item.get("kind") or "")
            run_id = item.get("run_id")
            if kind == "full":
                self._revise_saved_model(
                    int(run_id) if run_id is not None else None,
                    item.get("local_model") if isinstance(item.get("local_model"), dict) else {},
                    value if isinstance(value, dict) else None,
                )
                continue
            if run_id is None:
                continue
            self._accept_analysis(int(run_id), item, value)

    def _accept_analysis(self, run_id: int, item: dict, value: object) -> None:
        local = item.get("local")
        local_f = float(local) if isinstance(local, (int, float)) else None
        remote = float(value) if isinstance(value, (int, float)) else None
        field = str(item.get("field") or "")
        band = _grok_band(field)
        accepted = accept_grok(local_f, remote, band=band)
        session = self._session
        heaters_on = self._elements_on(self.store.get_settings())
        if (
            accepted
            and remote is not None
            and session is not None
            and self._run_id == run_id
            and not (session.phase in {"pulse", "pulses", "hold"} and heaters_on)
        ):
            apply_grok_value(session.model, field, remote)
            self._commit_model(self.store.get_settings())
        elif accepted and remote is not None and session is not None and session.phase in {"pulse", "pulses", "hold"} and heaters_on:
            with_value = dict(item)
            with_value["run_id"] = run_id
            self._analysis_inbox.append((with_value, remote))
            return
        self._record_analysis(run_id, str(item.get("kind") or ""), local_f, remote, accepted)

    def _revise_saved_model(self, run_id: int | None, local: dict, revised: dict | None) -> None:
        """A finished calibration may update the model the next run will load."""

        if run_id is None:
            return
        if not revised:
            self._record_analysis(run_id, "full", None, None, False)
            return
        current = self.store.get_settings()
        model = model_from_dict(current.thermal_model)
        accepted_any = False
        checks = (
            ("linear_rate_f_per_sec", "linear_rate_f_per_sec", GROK_RATE_BAND_F_PER_SEC),
            ("coast_rise_f", "coast_rise_f", GROK_RISE_BAND_F),
            ("cooldown_f_per_min", "cooldown_f_per_min", GROK_RATE_BAND_F_PER_MIN),
        )
        for key, _field, band in checks:
            local_value = local.get(key)
            remote_value = revised.get(key)
            local_f = float(local_value) if isinstance(local_value, (int, float)) else None
            remote_f = float(remote_value) if isinstance(remote_value, (int, float)) else None
            if not accept_grok(local_f, remote_f, band=band) or remote_f is None:
                continue
            accepted_any = True
            if key == "linear_rate_f_per_sec":
                model.linear_rate_f_per_sec = round(max(0.0, remote_f), 5)
            elif key == "coast_rise_f":
                model.coast_rise_f = round(max(0.0, remote_f), 2)
                if model.coast_seconds and model.coast_seconds > 0:
                    model.coast_quad = round(-model.coast_rise_f / (model.coast_seconds ** 2), 6)
            else:
                model.cooldown_f_per_min = round(min(COOLDOWN_RATE_MAX, max(0.0, remote_f)), 2)
        self._record_analysis(run_id, "full", None, None, accepted_any)
        if not accepted_any:
            return
        if self._session is not None and self._run_id == run_id:
            return
        learned = replace(
            current,
            thermal_model=model.to_dict(),
            learned_coast_f=model.coast_rise_f if model.coast_rise_f is not None else current.learned_coast_f,
            learned_coast_seconds=model.coast_seconds
            if model.coast_seconds is not None
            else current.learned_coast_seconds,
            learned_cooldown_f_per_min=model.cooldown_f_per_min
            if model.cooldown_f_per_min is not None
            else current.learned_cooldown_f_per_min,
        )
        self.store.save_settings(learned)

    def _record_analysis(
        self,
        run_id: int,
        kind: str,
        local: float | None,
        remote: float | None,
        accepted: bool,
    ) -> None:
        self.store.append_analysis(
            run_id,
            {
                "kind": kind,
                "local": local,
                "grok": remote,
                "accepted": accepted,
            },
        )
        elapsed = self._elapsed if self._run_id == run_id else None
        self._log(
            "analysis",
            analysis_message(kind, local, remote, accepted),
            {"kind": kind, "local": local, "grok": remote, "accepted": accepted},
            run_id=run_id,
            elapsed=elapsed,
        )

    def _clear_coast(self) -> None:
        self._run_kind = "run"
        self._program = None
        self._hold_started_at = None
        self._program_end = None
        self._charge_gallons = None
        self._session = None
        self._run_model = None
        self._coast_f = None
        self._coast_seconds = None
        self._calibration_settled = False
        self._pulse_until = None
        self._reset_model_run()

    def _reset_model_run(self) -> None:
        """Drop the climb, coast, and hold latch. The saved model stays."""

        self._hold_ready = False
        self._hold_released_at = None
        self._hold_bias_f = 0.0
        self._hold_peak_f = None
        self._hold_marked = False
        self._hold_mark_pending = False
        self._model_was_heating = False
        self._climb_coasting = False
        self._run_step = None
        self._last_target = None
        self._cool_to = None
        self._aim_seen = None
        self._coast_open_temp = None
        self._coast_open_slope = 0.0

    def _flush_hold_mark(self) -> None:
        """Write the Holding mark once the run row exists."""

        if not self._hold_mark_pending or self._run_id is None:
            return
        self._hold_mark_pending = False
        self._add_mark(MARK_HOLDING)

    def _clear_predict(self) -> None:
        self._predict_clock = 0.0
        self._predict_samples.clear()
        self._coast_curve.clear()

    def _clear_rate(self) -> None:
        self._rate_clock = 0.0
        self._rate_samples.clear()

    def _note_rate(self, dt: float) -> None:
        """Remember the control probe so the dashboard can show °F/min."""

        if dt <= 0:
            return
        self._rate_clock += dt
        found = self._current_control(self.store.get_settings())
        if found is None:
            self._rate_samples.clear()
            return
        self._rate_samples.append((self._rate_clock, found[1]))
        horizon = self._rate_clock - PREDICT_WINDOW_SECONDS
        while len(self._rate_samples) >= 2 and self._rate_samples[1][0] <= horizon:
            self._rate_samples.pop(0)

    def _temperature_rate(self) -> float | None:
        return slope_f_per_sec(self._rate_samples)

    def _note_predict(self, dt: float) -> None:
        """Append the control probe and drop readings older than the window."""

        if dt <= 0:
            return
        self._predict_clock += dt
        found = self._current_control(self.store.get_settings())
        if found is None:
            self._predict_samples.clear()
            return
        self._predict_samples.append((self._predict_clock, found[1]))
        horizon = self._predict_clock - PREDICT_WINDOW_SECONDS
        while len(self._predict_samples) >= 2 and self._predict_samples[1][0] <= horizon:
            self._predict_samples.pop(0)

    def _shutoff_coast(self, settings: Settings) -> float:
        """Degrees early to open the SSR.

        A short window leaves the learned coast unchanged so one jumped reading
        cannot move the shutoff. While the sheath is still heating, only the
        soaked fraction of that coast is used. A hot sheath uses the full
        prediction, widened when the live rise is faster.
        """

        rate = slope_f_per_sec(self._predict_samples)
        tau = settings.learned_coast_seconds
        soak = 1.0 if tau is None or tau <= 0 else self._sheath_soak(settings)
        if soak < SOAK_FULL:
            coast = predicted_coast_f(settings.learned_coast_f, tau, None) * soak
        else:
            coast = predicted_coast_f(settings.learned_coast_f, tau, rate)
        self._last_shutoff_coast = coast
        self._last_shutoff_rate = rate
        return coast

    def _sheath_soak(self, settings: Settings) -> float:
        """Hottest enabled sheath that is currently on, else the hottest enabled one."""

        tau = settings.learned_coast_seconds
        if tau is None or tau <= 0:
            return 1.0
        enabled = [index for index in range(SLOT_COUNT) if settings.heaters[index].enabled]
        if not enabled:
            return 1.0
        powered = [index for index in enabled if self._heaters[index]] or enabled
        return max(self._one_sheath_soak(index, tau) for index in powered)

    def _one_sheath_soak(self, index: int, tau: float) -> float:
        if self._heaters[index]:
            return sheath_soak(self._off_when_closed[index], self._heater_on_for[index], tau)
        hot = sheath_soak(self._off_when_closed[index], self._on_when_opened[index], tau)
        off = self._heater_off_for[index]
        if math.isinf(off):
            return 0.0
        return hot * math.exp(-max(0.0, off) / tau)

    def _elements_on(self, settings: Settings) -> bool:
        return any(
            self._heaters[index] and settings.heaters[index].enabled for index in range(SLOT_COUNT)
        )

    def _note_coast_curve(self, settings: Settings) -> None:
        """Remember the rise after the SSR opens, and drop it when heat returns."""

        if self._elements_on(settings):
            self._coast_curve.clear()
            self._coast_open_temp = None
            self._coast_open_slope = 0.0
            return
        found = self._current_control(settings)
        if found is None:
            return
        if self._coast_open_temp is None:
            self._coast_open_temp = found[1]
            session = self._session
            if session is not None and session.shutoff_slope > 0:
                self._coast_open_slope = session.shutoff_slope
            else:
                self._coast_open_slope = self._sheath_slope
        self._coast_curve.append((self._predict_clock, found[1]))
        horizon = self._predict_clock - COAST_WATCH_MAX_SECONDS
        while len(self._coast_curve) >= 2 and self._coast_curve[1][0] <= horizon:
            self._coast_curve.pop(0)

    def _coast_time_constant(self, settings: Settings) -> float | None:
        """Fitted decay from this shutoff, or the learned duration when it has not bent yet."""

        samples: list[tuple[float, float]] = list(self._coast_curve)
        fitted = coast_tau_seconds(samples) if len(samples) >= PREDICT_MIN_SAMPLES * 2 else None
        if fitted is not None:
            return fitted
        learned = settings.learned_coast_seconds
        if learned is None or learned <= 0:
            return None
        return float(learned)

    def _lookahead_model(self) -> ThermalModel | None:
        """The heating model, once the learning coast has finished or a run loaded one."""

        if self._run_model is not None and self._run_model.ready():
            return self._run_model
        session = self._session
        if (
            session is not None
            and session.model.ready()
            and session.phase in {"pulse", "pulses", "hold"}
        ):
            return session.model
        return None

    def _aim_temperature(self, settings: Settings) -> float:
        """Temperature the heaters are aiming at.

        A calibration scores the learning coast against 140°F, then pulses
        and holds at 160°F. The dial and the saved setpoint still belong to
        the next real run.
        """

        if self._run_kind == "calibration" and self._mode in ("running", "paused"):
            session = self._session
            if session is not None and session.phase in {"pulse", "pulses", "hold"}:
                return CALIBRATION_TEMP_F
            return LEARN_TEMP_F
        return float(self._target_value(settings))

    def _note_aim(self, aim: float, temp: float) -> None:
        """Remember a setpoint that stepped down, until the probe arrives.

        The comparison is against the previous aim, not the previous reading.
        A tenth of a degree of probe noise leaves the setpoint where it was.
        """

        previous = self._aim_seen
        self._aim_seen = aim
        if previous is not None and aim < previous - 0.5:
            self._cool_to = aim if temp > aim + HOLD_BAND_F else None
        elif self._cool_to is not None and aim > self._cool_to + 0.5:
            self._cool_to = None
        elif self._cool_to is not None and temp <= aim + HOLD_BAND_F:
            self._cool_to = None

    def _cooling_to_setpoint(self, temp: float, aim: float) -> bool:
        """True while this run is waiting to fall to a setpoint that was lowered."""

        if self._mode not in ("running", "paused"):
            return False
        self._note_aim(aim, temp)
        return self._cool_to is not None and temp > aim + HOLD_BAND_F

    def _forecast(self, settings: Settings) -> dict[str, float | None]:
        """Time to the target while rising, and time to cool on purpose.

        A falling reading at an unchanged setpoint is not a cooldown. Cooling
        time is the safe-to-handle line after a run, or a setpoint that was
        lowered, until the probe gets there.
        """

        empty: dict[str, float | None] = {"seconds_to_target": None, "seconds_to_cooldown": None}
        if self._mode not in ("running", "paused", "cooling"):
            return empty
        found = self._current_control(settings)
        if found is None:
            return empty
        _, temp = found
        rate = slope_f_per_sec(self._predict_samples)
        aim = self._aim_temperature(settings)
        heating = self._elements_on(settings)
        rising = rate is not None and rate >= PREDICT_MIN_RATE_F_PER_SEC and temp < aim
        stepping_down = self._cooling_to_setpoint(temp, aim)
        lookahead = self._lookahead_model()
        if self._mode != "cooling" and not stepping_down and lookahead is not None and (heating or rising):
            # The heating slope picks where on the coast the shutoff starts.
            # A sheath or probe reading below that curve does not lower it.
            on_seconds = (
                self._pulse_on_seconds(settings)
                if heating
                else self._opened_on_seconds(settings)
            )
            slope = self._session.sheath_slope if self._session is not None else self._sheath_slope
            if heating:
                if rate is not None and rate > slope:
                    slope = rate
                slope = coast_entry_slope(lookahead, on_seconds, slope)
            seconds = seconds_to_landing(
                temp,
                aim,
                on_seconds,
                lookahead,
                heating=heating,
                off_seconds=0.0 if heating else self._coast_off_seconds(settings),
                horizon=PREDICT_MAX_HORIZON_SECONDS,
                slope_f_per_sec=slope,
            )
            return {
                "seconds_to_target": _forecast_seconds(seconds),
                "seconds_to_cooldown": None,
            }
        if self._mode != "cooling" and not stepping_down and (heating or rising):
            if heating:
                use_rate = rate
                if settings.learned_coast_seconds:
                    use_rate = projected_linear_rate(rate, self._sheath_soak(settings))
                seconds = seconds_to_target(
                    temp,
                    aim,
                    self._shutoff_coast(settings),
                    use_rate,
                    settings.learned_coast_f,
                    settings.learned_coast_seconds,
                )
            else:
                tau = self._coast_time_constant(settings)
                if tau is None:
                    seconds = seconds_to_target(
                        temp,
                        aim,
                        predicted_coast_f(
                            settings.learned_coast_f,
                            settings.learned_coast_seconds,
                            rate,
                        ),
                        rate,
                        settings.learned_coast_f,
                        settings.learned_coast_seconds,
                    )
                else:
                    seconds = seconds_along_coast(temp, aim, rate, tau)
            return {
                "seconds_to_target": _forecast_seconds(seconds),
                "seconds_to_cooldown": None,
            }
        if self._mode != "cooling" and not stepping_down:
            return empty
        floor = SAFE_TEMP_F if self._mode == "cooling" else aim
        return {
            "seconds_to_target": None,
            "seconds_to_cooldown": _forecast_seconds(
                seconds_to_cooldown(
                    temp,
                    rate,
                    learned_rate_f_per_min=settings.learned_cooldown_f_per_min,
                    floor_f=floor,
                )
            ),
        }

    def _log_forecast(self, settings: Settings) -> None:
        forecast = self._forecast(settings)
        target = forecast["seconds_to_target"]
        cool = forecast["seconds_to_cooldown"]
        if target is None and cool is None:
            return
        logger.info(
            "Temperature forecast: %s to target, %s to cool",
            "n/a" if target is None else f"{target:.0f}s",
            "n/a" if cool is None else f"{cool:.0f}s",
        )

    def _hold_pulse(self, settings: Settings) -> tuple[float, float] | None:
        """Pulse length and reheat temperature, when a cooling rate can hold the target."""

        coast = settings.learned_coast_f
        seconds = settings.learned_coast_seconds
        rate = settings.learned_cooldown_f_per_min
        if coast is None or seconds is None or rate is None or rate <= 0:
            return None
        duration = sustain_pulse_seconds(coast, seconds)
        if duration is None:
            return None
        reheat = reheat_temperature(settings.target_temp_f, rate, duration)
        coast = settings.learned_coast_f or 0.0
        if reheat <= settings.target_temp_f - coast:
            return None
        return duration, reheat

    def _sustain_states(self, settings: Settings, primary: float, pulse: tuple[float, float]) -> list[bool]:
        """Approach on the learned coast, then pulse only after the pot has arrived.

        The climb turns the elements off at the early cutoff and leaves them
        off while stored heat finishes the rise. A pulse starts only after
        the probe has already been above the reheat point and then sagged
        back to it. Pulsing as soon as the cutoff is crossed heats the rest
        of the way to the target, and the learned coast then overshoots it.
        """

        duration, reheat = pulse
        target = float(settings.target_temp_f)
        enabled = [settings.heaters[index].enabled for index in range(SLOT_COUNT)]
        coast_f = self._shutoff_coast(settings)
        coast_line = target - coast_f
        if primary <= coast_line:
            # Below the coast, including a deep sag, this is a fresh approach.
            self._pulse_until = None
            self._hold_ready = False
            return [
                heater_should_be_on(
                    primary,
                    settings.target_temp_f,
                    bool(self._heaters[index]),
                    early_cutoff_f=coast_f,
                )
                and enabled[index]
                for index in range(SLOT_COUNT)
            ]
        if primary >= target:
            self._pulse_until = None
            self._hold_ready = True
            return [False] * SLOT_COUNT
        if self._pulse_until is not None and self._elapsed < self._pulse_until:
            return list(enabled)
        self._pulse_until = None
        if primary > reheat:
            self._hold_ready = True
            return [False] * SLOT_COUNT
        if not self._hold_ready:
            return [False] * SLOT_COUNT
        blocked = any(
            enabled[index]
            and not self._heaters[index]
            and self._heater_off_for[index] < settings.heater_min_off_seconds
            for index in range(SLOT_COUNT)
        )
        if not blocked:
            self._pulse_until = self._elapsed + duration
        return list(enabled)

    def _model_mask(self, settings: Settings, primary: float, model: ThermalModel) -> list[bool]:
        """Climb on the predicted crest, follow the projected coast, then hold.

        The hold lasts until Stop, pause, or an emergency. A raised target,
        or a sag one minimum pulse cannot bring back inside the band, climbs
        again. The saved model is not changed here.
        """

        target = float(self._target_value(settings))
        on = self._pulse_on_seconds(settings)
        if self._hold_ready and self._hold_should_release(primary, target, model, settings):
            self._hold_ready = False
            self._hold_released_at = None
            self._hold_bias_f = 0.0
            self._hold_peak_f = None
        self._last_target = target
        if self._hold_ready:
            return self._hold_mask(settings, primary, model, target, on)
        if not self._elements_on(settings) and self._projected_coast_pending(
            settings, primary, model, target
        ):
            return self._coast_mask(primary, model, target)
        if not self._elements_on(settings):
            self._climb_coasting = False
            if primary >= target - HOLD_BAND_F:
                return self._hold_mask(settings, primary, model, target, on)
        return self._climb_mask(settings, primary, model, target, on)

    def _hold_should_release(
        self,
        temp: float,
        target: float,
        model: ThermalModel,
        settings: Settings,
    ) -> bool:
        """True when the hold should give the climb the heaters back."""

        if (
            self._last_target is not None
            and target > self._last_target
            and temp < target - HOLD_BAND_F
        ):
            return True
        landing, _, _, _ = hold_pulse_landing(
            temp,
            model,
            settings.heater_min_on_seconds,
            self._sheath_slope,
        )
        return landing < target - HOLD_BAND_F
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
