anomaddev/Brewski/tests/test_menu.py

"""Software menu screens, and a Stop hold versus a short press."""

from brewski.menu import ITEMS, VISIBLE, SoftwareMenu, menu_title, scroll_hint
from brewski.panel import HOLD_RELEASE_OFF_SECONDS, STOP_HOLD_SECONDS, Panel
from brewski.updates import ReleaseInfo


class _Button:
    def __init__(self) -> None:
        self.when_pressed = None
        self.when_held = None
        self.when_released = None
        self.hold_time = 1


class _Leds:
    def set(self, start_on: bool, stop_on: bool) -> None:
        self.state = (start_on, stop_on)

    def close(self) -> None:
        self.closed = True


def _panel():
    stop = _Button()
    leds = _Leds()
    panel = Panel(_Button(), stop, leds, None)
    return panel, stop, leds


def test_a_stop_release_is_a_short_press(monkeypatch):
    panel, stop, _leds = _panel()
    now = {"t": 1_000.0}
    monkeypatch.setattr("brewski.panel.time.monotonic", lambda: now["t"])
    stop.is_pressed = True
    stop.when_pressed()
    now["t"] += 0.06
    stop.is_pressed = False
    stop.when_released()
    assert panel.take() == (0, 1, 0, 0)


def test_a_stop_spike_does_not_count_or_block_start(monkeypatch):
    now = {"t": 1_000.0}
    monkeypatch.setattr("brewski.panel.time.monotonic", lambda: now["t"])
    start = _Button()
    stop = _Button()
    leds = _Leds()
    panel = Panel(start, stop, leds, None)
    panel.set_leds(True, True)
    stop.is_pressed = True
    stop.when_pressed()
    assert leds.state == (False, False)
    now["t"] += 0.02
    stop.is_pressed = False
    stop.when_released()
    assert leds.state == (True, True)
    start.is_pressed = True
    start.when_pressed()
    now["t"] += 0.06
    start.is_pressed = False
    start.when_released()
    assert panel.take() == (1, 0, 0, 0)


def test_a_quick_stop_counts_when_the_release_callback_is_missed(monkeypatch):
    panel, stop, _leds = _panel()
    now = {"t": 1_000.0}
    monkeypatch.setattr("brewski.panel.time.monotonic", lambda: now["t"])
    stop.is_pressed = True
    stop.when_pressed()
    stop.is_pressed = False
    now["t"] += 0.06
    assert panel.take() == (0, 1, 0, 0)


def test_a_quick_start_counts_once_on_the_way_up(monkeypatch):
    now = {"t": 1_000.0}
    monkeypatch.setattr("brewski.panel.time.monotonic", lambda: now["t"])
    start = _Button()
    panel = Panel(start, _Button(), _Leds(), None)
    start.is_pressed = True
    start.when_pressed()
    start.when_pressed()
    assert panel.take() == (0, 0, 0, 0)
    now["t"] += 0.06
    start.is_pressed = False
    start.when_released()
    assert panel.take() == (1, 0, 0, 0)
    now["t"] += 0.05
    start.is_pressed = True
    start.when_pressed()
    now["t"] += 0.06
    start.is_pressed = False
    start.when_released()
    assert panel.take() == (1, 0, 0, 0)


def test_a_short_stop_still_counts_when_start_blips(monkeypatch):
    now = {"t": 1_000.0}
    monkeypatch.setattr("brewski.panel.time.monotonic", lambda: now["t"])
    start = _Button()
    stop = _Button()
    panel = Panel(start, stop, _Leds(), None)
    stop.is_pressed = True
    stop.when_pressed()
    start.is_pressed = True
    start.when_pressed()
    now["t"] += 0.02
    start.is_pressed = False
    start.when_released()
    now["t"] += 0.04
    stop.is_pressed = False
    stop.when_released()
    assert panel.take() == (0, 1, 0, 0)


def test_a_short_start_still_counts_when_stop_blips(monkeypatch):
    now = {"t": 1_000.0}
    monkeypatch.setattr("brewski.panel.time.monotonic", lambda: now["t"])
    start = _Button()
    stop = _Button()
    panel = Panel(start, stop, _Leds(), None)
    start.is_pressed = True
    start.when_pressed()
    stop.is_pressed = True
    stop.when_pressed()
    now["t"] += 0.02
    stop.is_pressed = False
    stop.when_released()
    now["t"] += 0.04
    start.is_pressed = False
    start.when_released()
    assert panel.take() == (1, 0, 0, 0)


def test_a_start_press_does_not_count_as_a_stop(monkeypatch):
    now = {"t": 1_000.0}
    monkeypatch.setattr("brewski.panel.time.monotonic", lambda: now["t"])
    start = _Button()
    stop = _Button()
    panel = Panel(start, stop, _Leds(), None)
    start.is_pressed = True
    start.when_pressed()
    now["t"] += 0.2
    stop.is_pressed = True
    stop.when_pressed()
    stop.is_pressed = False
    stop.when_released()
    assert panel.take() == (0, 0, 0, 0)
    start.is_pressed = False
    start.when_released()
    assert panel.take() == (1, 0, 0, 0)


def test_a_stop_press_does_not_count_as_a_start(monkeypatch):
    now = {"t": 1_000.0}
    monkeypatch.setattr("brewski.panel.time.monotonic", lambda: now["t"])
    start = _Button()
    stop = _Button()
    panel = Panel(start, stop, _Leds(), None)
    stop.is_pressed = True
    stop.when_pressed()
    start.is_pressed = True
    start.when_pressed()
    start.is_pressed = False
    start.when_released()
    assert panel.take() == (0, 0, 0, 0)
    now["t"] += 0.2
    stop.is_pressed = False
    stop.when_released()
    assert panel.take() == (0, 1, 0, 0)


def test_a_hold_after_a_finished_tap_cannot_reopen_the_menu(monkeypatch):
    panel, stop, _leds = _panel()
    now = {"t": 1_000.0}
    monkeypatch.setattr("brewski.panel.time.monotonic", lambda: now["t"])
    stop.is_pressed = True
    stop.when_pressed()
    generation = panel._gestures.stop.generation
    now["t"] += 0.2
    stop.when_released()
    stop.is_pressed = True
    panel._gestures.fire(generation)
    assert panel.take() == (0, 1, 0, 0)


def test_the_hold_timer_lights_the_lamp_before_the_next_poll(monkeypatch):
    panel, stop, leds = _panel()
    now = {"t": 1_000.0}
    monkeypatch.setattr("brewski.panel.time.monotonic", lambda: now["t"])
    panel.set_leds(True, True)
    stop.is_pressed = True
    stop.when_pressed()
    assert leds.state == (False, False)
    panel._gestures.fire(panel._gestures.stop.generation)
    assert leds.state == (False, True)
    assert panel.take() == (0, 0, 1, 0)
    stop.is_pressed = False
    stop.when_released()
    assert leds.state == (True, False)
    assert panel.take() == (0, 0, 0, 0)


def test_a_hold_that_arrives_after_release_is_ignored(monkeypatch):
    panel, stop, _leds = _panel()
    now = {"t": 1_000.0}
    monkeypatch.setattr("brewski.panel.time.monotonic", lambda: now["t"])
    stop.is_pressed = True
    stop.when_pressed()
    generation = panel._gestures.stop.generation
    now["t"] += 0.2
    stop.is_pressed = False
    stop.when_released()
    assert panel.take() == (0, 1, 0, 0)
    stop.is_pressed = True
    panel._gestures.fire(generation)
    assert panel.take() == (0, 0, 0, 0)


def test_the_hold_lamp_comes_on_and_goes_out_with_the_button(monkeypatch):
    panel, stop, leds = _panel()
    now = {"t": 1_000.0}
    monkeypatch.setattr("brewski.panel.time.monotonic", lambda: now["t"])
    panel.set_leds(True, True)
    stop.is_pressed = True
    stop.when_pressed()
    assert leds.state == (False, False)
    now["t"] += STOP_HOLD_SECONDS
    assert panel.take() == (0, 0, 1, 0)
    assert leds.state == (False, True)
    stop.is_pressed = False
    stop.when_released()
    assert leds.state == (True, False)
    assert panel.take() == (0, 0, 0, 0)
    now["t"] += HOLD_RELEASE_OFF_SECONDS
    panel.take()
    assert leds.state == (True, True)


def test_a_short_release_does_not_leave_a_hold_behind(monkeypatch):
    panel, stop, _leds = _panel()
    now = {"t": 1_000.0}
    monkeypatch.setattr("brewski.panel.time.monotonic", lambda: now["t"])
    stop.is_pressed = True
    stop.when_pressed()
    now["t"] += 0.2
    stop.is_pressed = False
    stop.when_released()
    assert panel.take() == (0, 1, 0, 0)
    assert panel.take() == (0, 0, 0, 0)


def test_software_menu_lines_and_leds():
    menu = SoftwareMenu()
    assert menu.lines("0.6.5") == [
        menu_title("v"),
        "> Program",
        "  About",
        "  Networking",
    ]
    assert len(menu.lines("0.6.5")[0]) == 20
    assert menu.leds() == (True, True)
    assert menu.move(2) is True
    assert menu.lines("0.6.5")[3] == "> Networking"
    menu.index = 0
    menu.top = 0
    assert menu.move(-1) is False
    assert menu.lines("0.6.5")[1] == "> Program"
    menu.index = len(ITEMS) - 1
    menu.top = len(ITEMS) - VISIBLE
    assert menu.move(1) is False
    assert menu.lines("0.6.5")[3] == "> Reboot"
    assert menu.lines("0.6.5")[0] == menu_title("^")
    menu.select()
    assert menu.lines("0.6.5") == ["Reboot the Pi?", "START reboot", "STOP cancel", ""]
    assert menu.leds() == (True, True)
    assert menu.back() is True
    assert menu.lines("0.6.5")[0].startswith("Software Menu")

    menu.index = 1
    menu.select()
    assert menu.lines("9.9.9") == ["About", "Brewski", "Release 9.9.9", "STOP back"]
    installed = "abc1234" + "a" * 33
    assert menu.lines("9.9.9", update_source="beta", revision=installed) == [
        "About",
        "Brewski",
        "Commit abc1234",
        "STOP back",
    ]
    assert menu.lines("9.9.9", update_source="beta", revision="v9.9.9") == [
        "About",
        "Brewski",
        "Release 9.9.9",
        "STOP back",
    ]
    assert menu.leds() == (False, True)
    assert menu.select() is None

    menu.back()
    menu.index = 4
    assert menu.select() == "check"
    assert menu.lines("0.6.5")[1] == "Checking..."
    menu.show_release(
        ReleaseInfo(current="0.6.5", latest="0.6.5", available=False, reachable=True),
        False,
    )
    assert menu.lines("0.6.5") == ["Check for Update", "Up to date", "0.6.5", "STOP back"]
    assert menu.leds() == (False, True)

    menu.show_release(
        ReleaseInfo(current="0.6.5", latest=None, available=False, reachable=False),
        False,
    )
    assert menu.lines("0.6.5")[1] == "GitHub unreachable"

    menu.show_release(
        ReleaseInfo(current="0.6.5", latest="0.6.6", available=True, reachable=True),
        False,
    )
    assert menu.lines("0.6.5")[2] == "Cannot install here"
    assert menu.select() is None

    menu.show_release(
        ReleaseInfo(current="0.6.5", latest="0.6.6", available=True, reachable=True),
        True,
    )
    assert menu.lines("0.6.5")[2] == "START install"
    assert menu.leds() == (True, True)
    assert menu.select() == "apply"

    menu.screen = "reboot"
    menu.failed = False
    menu.select()
    assert menu.lines("0.6.5")[0] == "Rebooting"
    assert menu.leds() == (False, False)
    menu.fail_reboot()
    assert menu.lines("0.6.5")[0] == "Reboot failed"
    assert menu.lines("0.6.5")[1] == "No permission"
    assert menu.leds() == (False, True)


def test_the_menu_scrolls_when_the_highlight_leaves_the_window():
    menu = SoftwareMenu()
    menu.move(5)
    assert menu.lines("0.6.5") == [
        menu_title("^"),
        "  Test Suite",
        "  Check for Update",
        "> Reboot",
    ]
    assert menu.move(1) is False
    opened = menu.lines("0.6.5")
    assert opened[3] == "> Reboot"
    assert opened[0] == menu_title("^")
    assert "About" not in opened[1:]
    assert scroll_hint(1, 3, 5) == "^v"
    assert scroll_hint(0, 3, 3) == ""


def test_networking_screen_shows_the_address_and_hostname():
    menu = SoftwareMenu()
    menu.index = 2
    assert menu.select() is None
    assert menu.screen == "networking"
    assert menu.leds() == (False, True)
    assert menu.lines("0.6.5", address="192.168.1.42:8080", hostname="stillpi") == [
        "Networking",
        "192.168.1.42:8080",
        "Host:        stillpi",
        "STOP back",
    ]
    clipped = menu.lines("0.6.5", address="", hostname="this-hostname-is-way-too-long")
    assert clipped[1] == "No address"
    assert clipped[2] == "Host: this-hostname-"
    assert all(len(line) <= 20 for line in clipped)
    assert menu.select() is None
    assert menu.back() is True
    assert menu.screen == "list"


def test_test_suite_confirms_before_initial_heating():
    menu = SoftwareMenu()
    menu.index = 3
    assert menu.select() is None
    assert menu.screen == "suite"
    assert menu.lines("0.6.5") == [
        "Test Suite",
        "> Initial Heating",
        "",
        "",
    ]
    assert menu.leds() == (True, True)
    assert menu.select() is None
    assert menu.screen == "suite-confirm"
    assert menu.lines("0.6.5") == [
        "Initial Heating?",
        "On 3 min, off 3 min",
        "START begin",
        "STOP cancel",
    ]
    assert menu.back() is True
    assert menu.screen == "suite"
    menu.select()
    assert menu.select() == "test"
    assert menu.chosen_test == "initial_heating"
    menu.show_notice("Result still up", "End it first")
    assert menu.lines("0.6.5")[0] == "Result still up"
    assert menu.leds() == (False, True)
    assert menu.back() is True
    assert menu.screen == "list"


def test_hold_editor_changes_one_field_and_toggles_continuous():
    menu = SoftwareMenu()
    menu.load_program(165, True, 3600)
    menu.index = 0
    assert menu.select() is None
    assert menu.screen == "program"
    assert menu.lines("0.6.5")[1] == "> Hold"
    assert menu.select() is None
    assert menu.screen == "hold"
    assert menu.lines("0.6.5")[1].startswith("> Target")
    assert menu.lines("0.6.5")[1].endswith("165 F")
    assert menu.select() is None
    assert menu.editing is True
    assert menu.lines("0.6.5")[0].startswith("Editing")
    assert menu.nudge(2) is True
    assert menu.lines("0.6.5")[1].endswith("167 F")
    assert menu.select() == "program-save"
    assert menu.editing is False
    assert menu.target == 167
    menu.move(4)
    assert "Continuous" in menu.lines("0.6.5")[3]
    assert menu.select() == "program-save"
    assert menu.continuous is False
    assert menu.back() is True
    assert menu.screen == "program"
    assert all(len(line) <= 20 for line in menu.lines("0.6.5"))
