anomaddev/Brewski/tests/test_v060.py

"""v0.6.0: emergency stop, the target dial, and live-source selection."""

import threading

import pytest

from brewski import __version__
from brewski.cli import _build_runtime
from brewski.controller import Controller, ControllerError
from brewski.emergency import CODES, check_code_list
from brewski.panel import indicator_leds
from brewski.sources.hts221 import calibration_from_bytes, compensate
from brewski.sources.max31865 import config_write, conversion_faulted, decode_rtd, temperature_f
from brewski.store import merge_settings
from brewski.updates import ReleaseInfo


class _Panel:
    def __init__(self, events):
        self.events = events

    def take(self):
        events = self.events
        self.events = (0, 0, 0, 0)
        return events

    def set_leds(self, *_args):
        return None

    def close(self):
        return None


def test_emergency_codes_reject_a_duplicate_or_a_renumbered_id():
    check_code_list([item.code for item in CODES])
    with pytest.raises(ValueError):
        check_code_list(["E01", "E01", "E03", "E04"])
    with pytest.raises(ValueError):
        check_code_list(["E01", "E03", "E04"])
    with pytest.raises(ValueError):
        check_code_list(["E02", "E01", "E03", "E04"])


def test_panel_leds_follow_the_action():
    assert indicator_leds("idle", emergency=False) == (True, True)
    assert indicator_leds("running", emergency=False) == (False, True)
    assert indicator_leds("paused", emergency=False) == (True, True)
    assert indicator_leds("cooling", emergency=False) == (True, True)
    assert indicator_leds("idle", emergency=True) == (False, True)
    assert indicator_leds("cooling", emergency=True) == (False, True)
    assert indicator_leds("running", emergency=True) == (False, True)
    assert indicator_leds("paused", emergency=True) == (False, True)


def test_encoder_step_shows_on_the_display_before_it_is_saved(controller, store):
    controller._panel = _Panel((0, 0, 0, 5))
    assert controller._apply_panel() is True
    assert store.get_settings().target_temp_f == 165
    assert "170 F" in controller._display.lines[1]
    assert controller.status()["target_temp_f"] == 170
    controller._flush_dial_target()
    assert store.get_settings().target_temp_f == 170


def test_encoder_step_saves_the_target(controller, store):
    controller._panel = _Panel((0, 0, 0, 1))
    controller.tick(0)
    assert store.get_settings().target_temp_f == 166

    store.save_settings(merge_settings(store.get_settings(), {"target_temp_f": 240}))
    controller._panel = _Panel((0, 0, 0, 1))
    controller.tick(0)
    assert store.get_settings().target_temp_f == 240

    store.save_settings(merge_settings(store.get_settings(), {"target_temp_f": 90}))
    controller._panel = _Panel((0, 0, 0, -1))
    controller.tick(0)
    assert store.get_settings().target_temp_f == 90


def test_uncalibrated_start_begins_calibration_and_stop_does_nothing_before_that(store, source):
    store.save_settings(merge_settings(store.get_settings(), {"setup_complete": True, "charge_gallons": 5}))
    controller = Controller(store, source)
    controller._panel = _Panel((0, 1, 0, 0))
    controller.tick(0)
    assert controller.status()["mode"] == "idle"

    controller._panel = _Panel((1, 0, 0, 0))
    controller.tick(0)
    status = controller.status()
    assert status["mode"] == "running"
    assert status["run_kind"] == "calibration"
    controller.shutdown()


def test_cabinet_over_the_limit_opens_every_ssr_and_refuses_start(controller, source):
    store = controller.store
    store.save_settings(merge_settings(store.get_settings(), {"heater_min_on_seconds": 30}))
    controller.start()
    controller.tick(1)
    assert any(source.heaters)
    source.cabinet_temp_f = 171
    controller.tick(0.2)
    status = controller.status()
    assert status["emergency_codes"] == ["E01"]
    assert status["emergency"][0]["summary"].startswith("Cabinet temperature")
    assert status["mode"] != "running"
    assert status["heaters_on"] == [False, False]
    assert source.heaters == [False, False]
    with pytest.raises(ControllerError) as caught:
        controller.start()
    assert caught.value.status == 409
    source.cabinet_temp_f = 170
    controller.tick(0.2)
    assert controller.status()["emergency_codes"] == []
    controller.start()


def test_unanswered_cabinet_sensor_trips_and_a_disabled_one_does_not(controller, source, store):
    source.climate_fault = True
    controller.tick(1)
    assert controller.status()["emergency_codes"] == ["E02"]
    with pytest.raises(ControllerError):
        controller.start()

    gpio = store.get_settings().gpio.to_dict()
    for device in gpio["i2c_devices"]:
        if device["id"] == "hts221":
            device["enabled"] = False
    store.save_settings(merge_settings(store.get_settings(), {"gpio": gpio}))
    source.cabinet_temp_f = 190
    controller.tick(1)
    assert controller.status()["emergency_codes"] == []
    assert controller.status()["cabinet_enabled"] is False
    controller.start()


def test_control_probe_fault_forces_heaters_off(controller, source):
    controller.start()
    controller.tick(1)
    assert any(source.heaters)
    source.probe_faults = [True, False]
    controller.tick(0.2)
    status = controller.status()
    assert status["emergency_codes"] == ["E03"]
    assert status["heaters_on"] == [False, False]
    assert source.heaters == [False, False]
    assert status["temps_f"][0] is None


def test_max31865_and_hts221_conversions():
    raw = round(100 / 430 * 32768)
    assert temperature_f(raw, 430, 100) == pytest.approx(32.0, abs=0.2)
    reading, fault = decode_rtd(0x3A, 0x01)
    assert fault is True
    assert reading == 0x1D00


def test_latched_max31865_fault_is_not_a_temperature():
    # Boiler capture: fault bit set and fault register 0x04 (undervoltage).
    # The same RTD code with that latch cleared is a real reading.
    assert conversion_faulted(0x41, 0xCB, 0x04) is True
    assert conversion_faulted(0x41, 0xC8, 0x00) is False
    assert temperature_f(decode_rtd(0x41, 0xC8)[0], 430, 100) == pytest.approx(80.51, abs=0.05)
    assert config_write(2) == 0xC2
    assert config_write(3) == 0xD2

    block = bytearray(16)
    block[1] = 200
    block[3] = 0x20
    block[5] = 0x0C
    block[10] = 100
    block[14] = 100
    calibration = calibration_from_bytes(bytes(block))
    temp_f, humidity = compensate(calibration, 40, 25)
    assert humidity == pytest.approx(40.0)
    assert temp_f == pytest.approx(77.0)


def test_installed_service_uses_the_pi_source(monkeypatch, tmp_path):
    monkeypatch.setenv("BREWSKI_DATA_DIR", str(tmp_path))

    def refuse_dummy(*_args, **_kwargs):
        raise AssertionError("the installed service must not construct DummySource")

    monkeypatch.setattr("brewski.cli.DummySource", refuse_dummy)

    class FakePi:
        name = "pi"

        def __init__(self, store, status=None):
            self.store = store
            self.status = status

        def read_temperatures(self, count):
            return [70.0, 62.0][:count]

        def set_heaters(self, states):
            return None

        def read_climate(self):
            return 70.0, 40.0

        def close(self):
            return None

    monkeypatch.setattr("brewski.sources.pi.PiSource", FakePi)
    controller, _app = _build_runtime(False)
    assert isinstance(controller.source, FakePi)
    assert controller.source.name == "pi"
    assert callable(controller.source.status)
    controller.shutdown()


def test_dev_command_still_uses_the_dummy_source(monkeypatch, tmp_path):
    monkeypatch.setenv("BREWSKI_DATA_DIR", str(tmp_path))
    controller, _app = _build_runtime(True)
    assert controller.source.name == "dummy"
    controller.shutdown()


def test_stop_hold_opens_the_software_menu_without_changing_the_target(controller, store):
    controller._panel = _Panel((0, 0, 1, 1))
    assert controller._apply_panel() is True
    assert controller._display.lines == [
        "Software Menu      v",
        "> Program",
        "  About",
        "  Networking",
    ]
    assert store.get_settings().target_temp_f == 165
    assert controller.status()["target_temp_f"] == 165

    controller._panel = _Panel((0, 0, 0, 5))
    controller._apply_panel()
    assert controller._display.lines[3] == "> Reboot"
    assert store.get_settings().target_temp_f == 165
    assert controller.status()["target_temp_f"] == 165

    controller._panel = _Panel((0, 0, 0, -5))
    controller._apply_panel()
    assert controller._display.lines[1] == "> Program"

    controller._panel = _Panel((0, 0, 0, 1))
    controller._apply_panel()
    assert controller._display.lines[2] == "> About"
    controller._panel = _Panel((1, 0, 0, 0))
    controller._apply_panel()
    assert controller._display.lines == ["About", "Brewski", f"Release {__version__}", "STOP back"]

    controller._panel = _Panel((0, 1, 0, 0))
    controller._apply_panel()
    assert controller._display.lines[0].startswith("Software Menu")

    controller._panel = _Panel((0, 1, 0, 0))
    controller._apply_panel()
    assert controller._menu is None
    assert controller._display.lines[0] == "Hold:"

    controller._panel = _Panel((0, 0, 1, 0))
    controller._apply_panel()
    assert controller._menu is not None
    assert controller._display.lines[0].startswith("Software Menu")


def test_about_shows_the_commit_when_beta_is_installed(controller, store, monkeypatch):
    store.save_settings(merge_settings(store.get_settings(), {"update_source": "beta"}))
    monkeypatch.setattr(
        "brewski.controller.installed_revision",
        lambda: "abc1234" + "d" * 33,
    )
    controller._panel = _Panel((0, 0, 1, 0))
    controller._apply_panel()
    controller._panel = _Panel((0, 0, 0, 1))
    controller._apply_panel()
    controller._panel = _Panel((1, 0, 0, 0))
    controller._apply_panel()
    assert controller._display.lines == ["About", "Brewski", "Commit abc1234", "STOP back"]


def test_stop_hold_during_a_run_does_not_stop_or_open_the_menu(controller):
    controller.start()
    controller._panel = _Panel((0, 0, 1, 0))
    assert controller._apply_panel() is False
    assert controller.status()["mode"] == "running"
    assert controller._menu is None

    controller._panel = _Panel((0, 1, 0, 0))
    controller._apply_panel()
    assert controller.status()["mode"] != "running"
    assert controller._menu is None


def test_stop_hold_during_an_emergency_opens_the_software_menu(controller):
    controller._emergency = ["E01"]
    controller._panel = _Panel((0, 0, 1, 0))
    assert controller._apply_panel() is True
    assert controller._display.lines[0].startswith("Software Menu")

    controller._panel = _Panel((0, 1, 0, 0))
    controller._apply_panel()
    assert controller._menu is None
    assert controller._display.lines[0].startswith("Emergency:")


def test_an_emergency_does_not_close_an_open_software_menu(controller):
    controller._panel = _Panel((0, 0, 1, 0))
    controller._apply_panel()
    controller._emergency = ["E03"]
    controller._panel = _Panel((0, 0, 0, 0))
    controller._apply_panel()
    assert controller._menu is not None
    assert controller._display.lines[0].startswith("Software Menu")


def test_cooling_hold_opens_the_software_menu(controller):
    controller._mode = "cooling"
    controller._panel = _Panel((0, 0, 1, 0))
    assert controller._apply_panel() is True
    assert controller._display.lines[0].startswith("Software Menu")


def test_software_menu_closes_when_a_run_starts(controller):
    controller._panel = _Panel((0, 0, 1, 0))
    controller._apply_panel()
    controller.start()
    controller._panel = _Panel((0, 0, 0, 0))
    controller._apply_panel()
    assert controller._menu is None
    assert controller._display.lines[0].startswith("Running:")


def _open_update_item(controller):
    controller._panel = _Panel((0, 0, 1, 0))
    controller._apply_panel()
    controller._panel = _Panel((0, 0, 0, 4))
    controller._apply_panel()
    controller._panel = _Panel((1, 0, 0, 0))
    controller._apply_panel()


def test_menu_check_shows_an_update_and_start_installs_it(controller, monkeypatch):
    info = ReleaseInfo(current="0.6.5", latest="0.6.6", available=True, reachable=True)
    monkeypatch.setattr("brewski.controller.check_release", lambda **_kwargs: info)
    monkeypatch.setattr("brewski.controller.apply_supported", lambda: True)
    started = []
    monkeypatch.setattr(controller, "start_update", lambda: started.append(True) or {})
    _open_update_item(controller)
    controller._menu_check_thread.join(2)
    controller._apply_panel()
    assert controller._display.lines[1] == "0.6.5 -> 0.6.6"
    assert controller._display.lines[2] == "START install"
    controller._panel = _Panel((1, 0, 0, 0))
    controller._apply_panel()
    assert started == [True]
    assert controller._menu is None


def test_menu_check_on_a_mac_does_not_offer_install(controller, monkeypatch):
    info = ReleaseInfo(current="0.6.5", latest="0.6.6", available=True, reachable=True)
    monkeypatch.setattr("brewski.controller.check_release", lambda **_kwargs: info)
    monkeypatch.setattr("brewski.controller.apply_supported", lambda: False)
    _open_update_item(controller)
    controller._menu_check_thread.join(2)
    controller._apply_panel()
    assert controller._display.lines[2] == "Cannot install here"
    assert controller._display.lines[3] == "STOP back"
    controller._panel = _Panel((1, 0, 0, 0))
    controller._apply_panel()
    assert controller._menu is not None
    assert controller._menu.screen == "update"


def test_menu_check_cancel_drops_a_late_result(controller, monkeypatch):
    started = threading.Event()
    gate = threading.Event()
    info = ReleaseInfo(current="0.6.5", latest=None, available=False, reachable=False)

    def blocked(**_kwargs):
        started.set()
        assert gate.wait(2)
        return info

    monkeypatch.setattr("brewski.controller.check_release", blocked)
    monkeypatch.setattr("brewski.controller.apply_supported", lambda: False)
    _open_update_item(controller)
    assert controller._display.lines[1] == "Checking..."
    assert started.wait(2)
    controller._panel = _Panel((0, 1, 0, 0))
    controller._apply_panel()
    gate.set()
    controller._menu_check_thread.join(2)
    assert controller._display.lines[0].startswith("Software Menu")


def test_networking_screen_shows_how_to_open_the_dashboard(controller, monkeypatch):
    monkeypatch.setattr(
        "brewski.controller.display_identity",
        lambda: ("192.168.1.42:8080", "stillpi"),
    )
    controller._panel = _Panel((0, 0, 1, 0))
    controller._apply_panel()
    controller._panel = _Panel((0, 0, 0, 2))
    controller._apply_panel()
    controller._panel = _Panel((1, 0, 0, 0))
    controller._apply_panel()
    assert controller._display.lines == [
        "Networking",
        "192.168.1.42:8080",
        "Host:        stillpi",
        "STOP back",
    ]


def test_menu_reboot_confirms_then_reports_a_refusal(controller, monkeypatch):
    def refuse():
        raise OSError("nope")

    monkeypatch.setattr("brewski.controller.request_reboot", refuse)
    controller._panel = _Panel((0, 0, 1, 0))
    controller._apply_panel()
    controller._panel = _Panel((0, 0, 0, 5))
    controller._apply_panel()
    assert controller._display.lines[3] == "> Reboot"
    controller._panel = _Panel((1, 0, 0, 0))
    controller._apply_panel()
    assert controller._display.lines[:3] == ["Reboot the Pi?", "START reboot", "STOP cancel"]
    controller._panel = _Panel((1, 0, 0, 0))
    controller._apply_panel()
    assert controller._display.lines[0] == "Reboot failed"
    assert controller._display.lines[1] == "No permission"
    controller._panel = _Panel((0, 1, 0, 0))
    controller._apply_panel()
    assert controller._display.lines[0].startswith("Software Menu")
