anomaddev/Brewski/(commit log)

2026-10-17 Replace the mock UI with an installable still controller (#1)
    * Replace the mock UI with an installable still controller.
    Brewski now serves a dark JavaScript dashboard, simulates the heaters and probes, and stores each run's settings and readings so the controller can be developed before the Raspberry Pi I/O exists.
    * Open a run when any part of its history row is clicked.
    The date was the only link, so a click on the duration or status did nothing.
    * Turn the dashboard into a dark control surface.
    Probe temperatures are large readouts, heaters are tiles, and settings use segmented choices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
2026-10-18 Cut v0.6.0 so the installed controller drives the Pi hardware.
    The service uses the live SSRs, MAX31865, and HTS221, keeps the panel dial and solid action LEDs in step with the still, and stops the heaters when a cabinet or probe emergency is active. Dummy stays the Mac dev stand-in.
2026-10-18 Cut v0.6.1 so the next boot prompt can light the panel LEDs.
2026-10-18 Cut v0.6.3 so a 2-wire probe reads ambient, the dial tracks the display, and the LED relays light the right way.
2026-10-18 Cut v0.6.4 so the target on the LCD keeps up with the dial.
2026-10-18 Cut v0.6.5 so calibration waits for the real coast and learns how fast the pot cools.
    A short flat window was saving the coast while the kettle was still climbing. The run now records the crest, measures the cooling rate, and pulses the heaters near the target.
2026-10-18 Cut v0.6.6 so a long press of Stop opens a software menu, and the dashboard sits the cabinet with the heaters.
2026-10-19 Cut v0.6.7 so a long press of Stop opens the software menu during an emergency.
2026-10-19 Cut v0.6.8 so the software menu opens after holding Stop for 4 seconds.
2026-10-19 Cut v0.6.9 so Stop is one gesture and the software menu keeps up with the dial.
2026-10-19 Cut v0.6.10 so a quick press still registers and the Stop lamp marks a long hold.
2026-10-19 Cut v0.6.11 so the update prompt lights the start and stop lamps.
2026-10-19 Cut v0.6.12 so a Stop hold lights its lamp at 4 seconds and is not also a tap.
2026-10-19 Cut v0.6.13 so one button press stays one gesture.
2026-10-19 Cut v0.6.14 so a run coasts in on the learned cutoff.
2026-10-19 Cut v0.6.15 so a noise spike is not a press and a latched probe fault clears.
2026-10-19 Cut v0.6.16 so the panel opens again.
2026-10-19 Cut v0.6.17 so holding Stop does not light the Start lamp.
2026-10-19 Cut v0.6.18 so Start registers while Stop sits closed.
2026-10-19 Cut v0.6.19 so an update is not blocked by leftover packages.
2026-10-19 Cut v0.6.20 so an update does not try to remove Debian packages.
2026-10-19 Cut v0.6.21 so opening Stop does not close the panel.
2026-10-19 Cut v0.6.22 so the panel does not write debug logs.
2026-10-19 Cut v0.6.23 so a temperature gap reads as off and the board files are in the tree.
2026-10-19 ignore pcb design
2026-10-19 settings tweaks & LED pin updates
2026-10-21 calibration v2.0
2026-10-21 Hold calibration with the coast a minimum pulse actually stores. (#6)
    A 1s pulse was planned as ramp times minimum on time, so the hold fired again as soon as the off dwell elapsed and stacked several degrees of sheath coast above 160°F. Landings now include that coast, the next pulse waits until the probe is falling or one coast time constant has passed, and one tick can change the SSR only once.
